griffink3/sak-redesign/Finite Element/Utensil_Lock_2_Stress_Plot.PNG

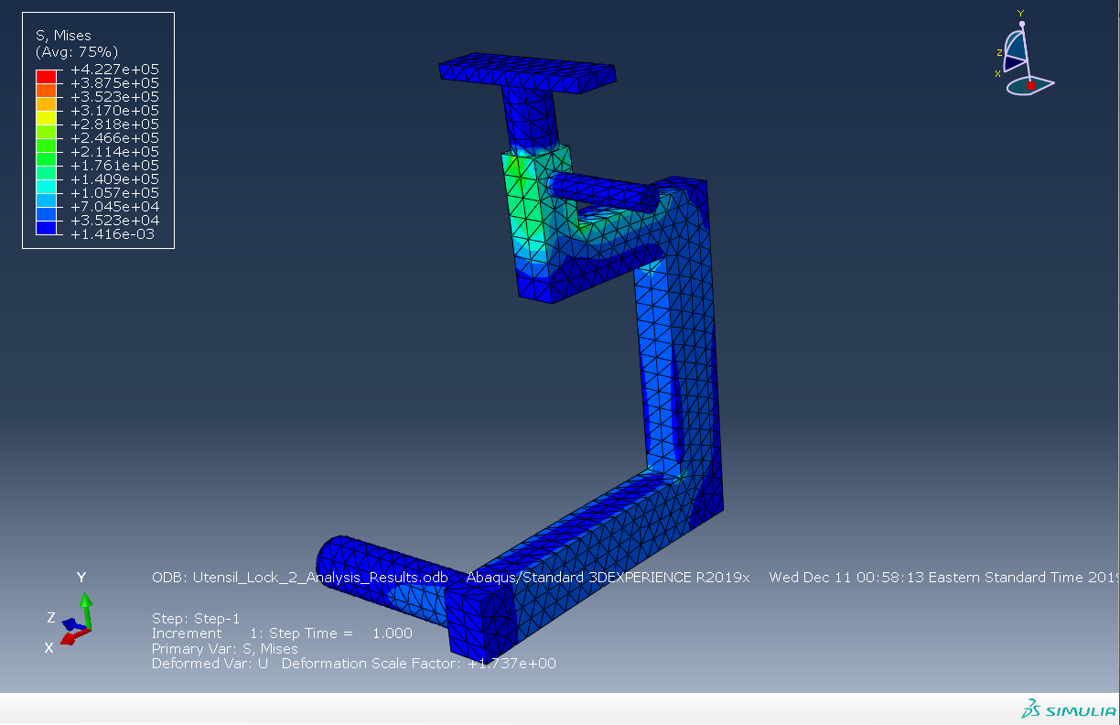
Finite Element/Utensil_Lock_2_Stress_Plot.PNG
