griffink3/sak-redesign/Finite Element/Bottle_Opener_Plot.PNG

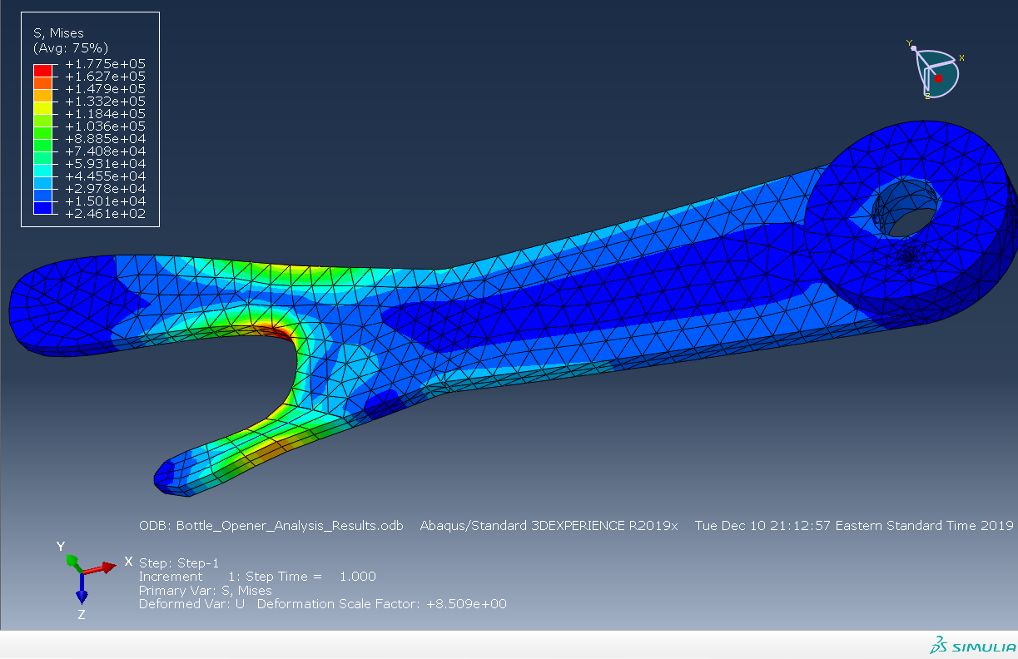
Finite Element/Bottle_Opener_Plot.PNG
