griffink3/sak-redesign/Finite Element/Fork_Stress_Plot.PNG

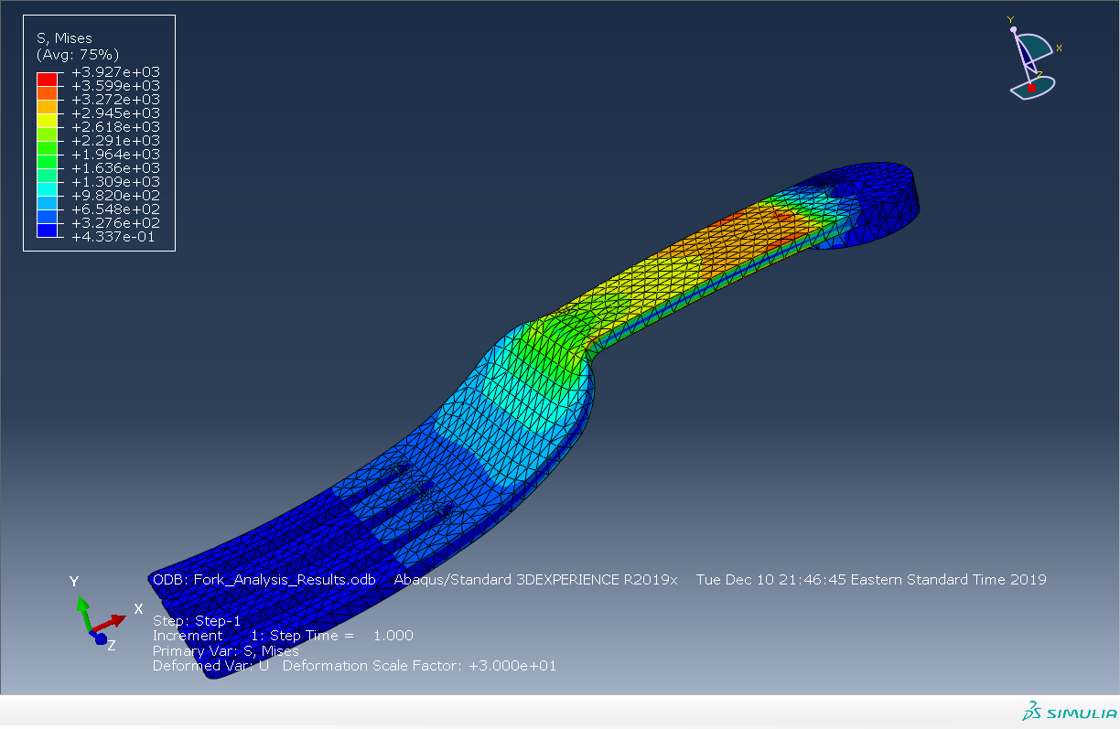
Finite Element/Fork_Stress_Plot.PNG
