griffink3/sak-redesign/Finite Element/Knife_Stress_Plot.PNG

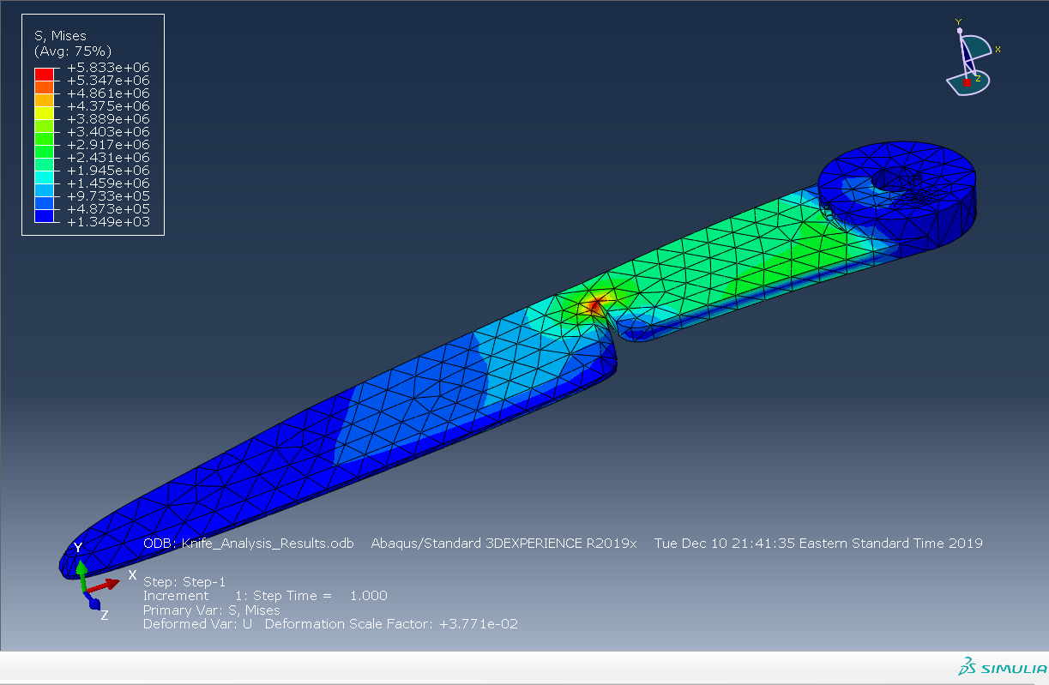
Finite Element/Knife_Stress_Plot.PNG
