griffink3/sak-redesign/Finite Element/Spoon_Stress_Plot.PNG

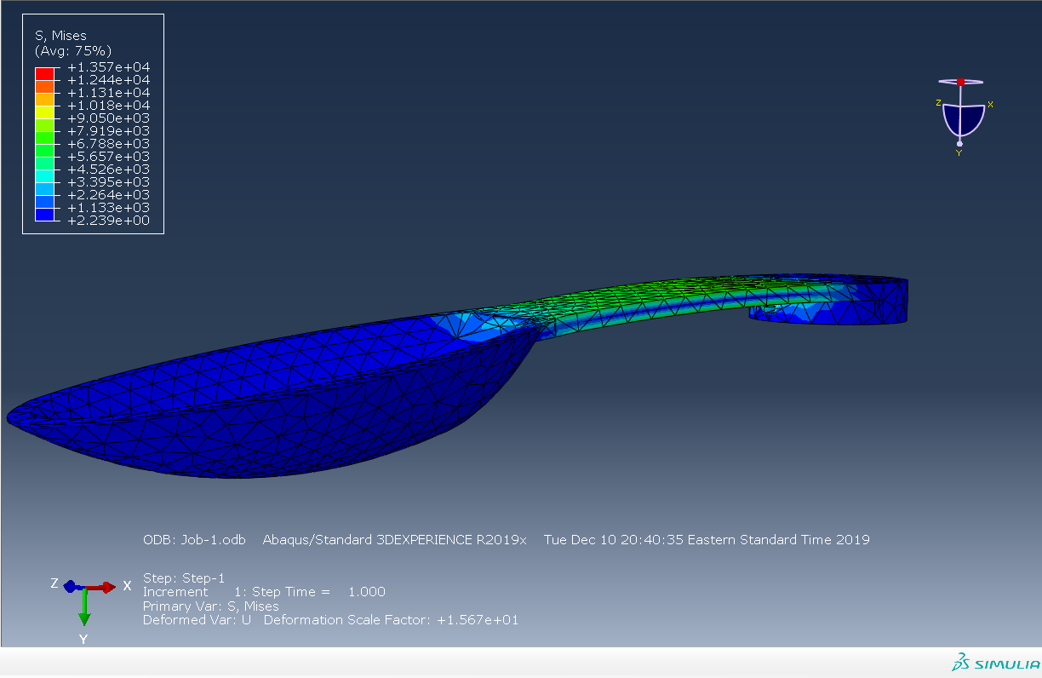
Finite Element/Spoon_Stress_Plot.PNG
