griffink3/sak-redesign/Finite Element/Utensil_Lock_1_Stress_Plot.PNG

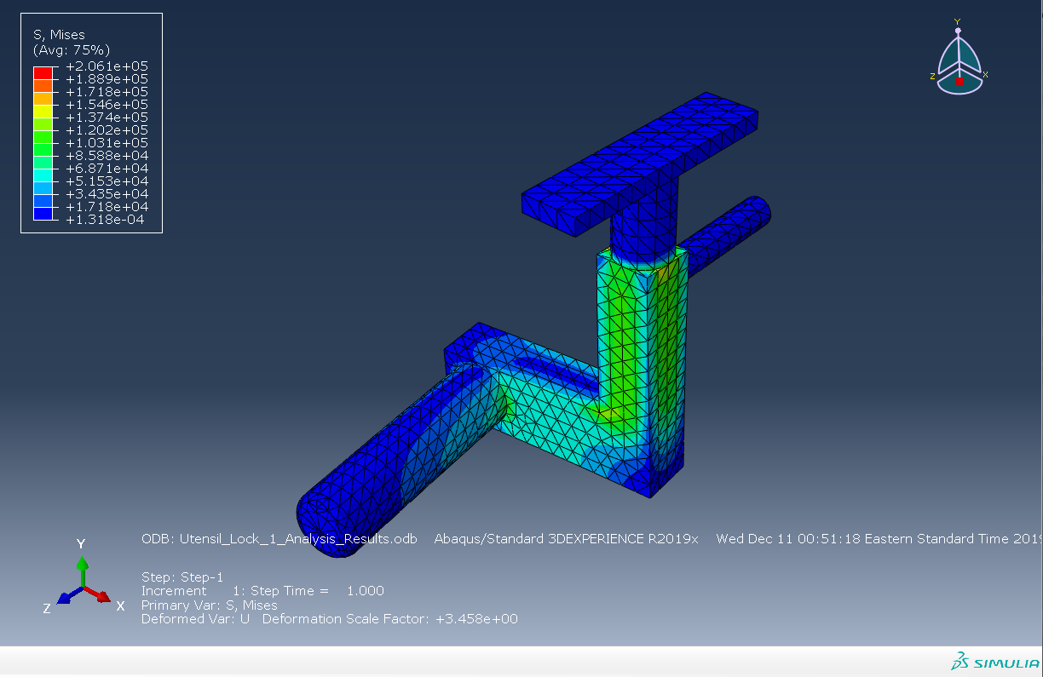
Finite Element/Utensil_Lock_1_Stress_Plot.PNG
