griffink3/sak-redesign/CAM /Top_Rotation_Piece_CAM.SLDPRT

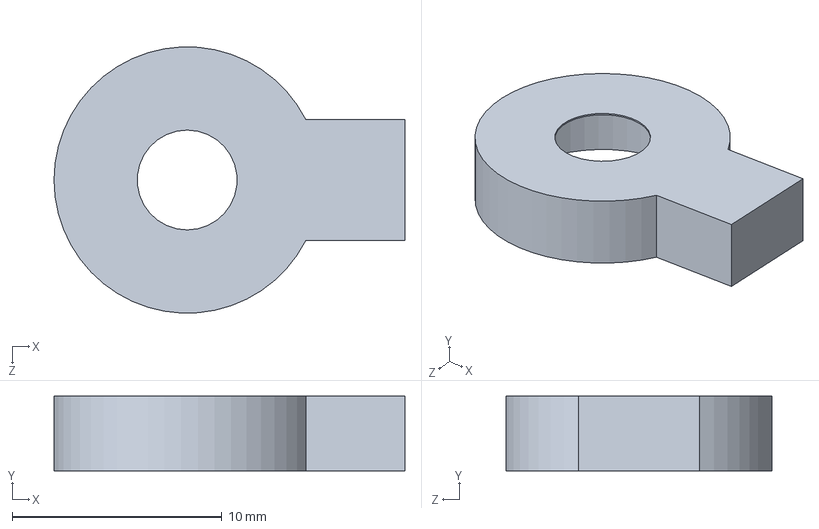
[picture p16: CAD file, 2019-12-22]
CAM /Top_Rotation_Piece_CAM.SLDPRT
16.7 x 3.56 x 12.7 mm
