griffink3/sak-redesign/CAM /Utensil_Bottle_Opener_CAM.SLDPRT

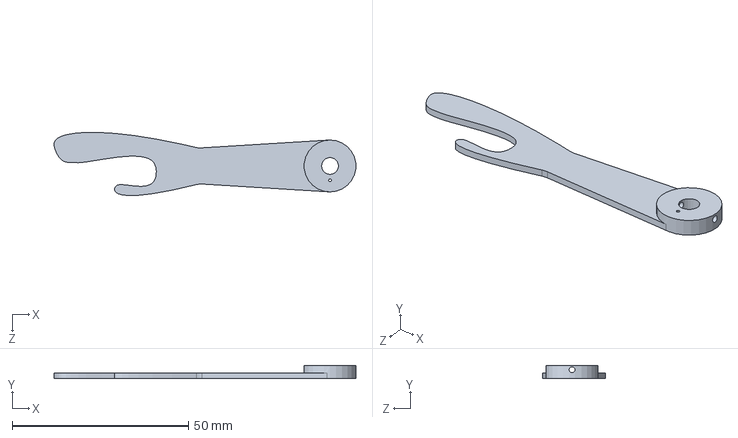
[picture p17: CAD file, 2019-12-22]
CAM /Utensil_Bottle_Opener_CAM.SLDPRT
85.7 x 3.81 x 17.9 mm
