griffink3/sak-redesign/Design Package/Assembly_Drawings.PDF

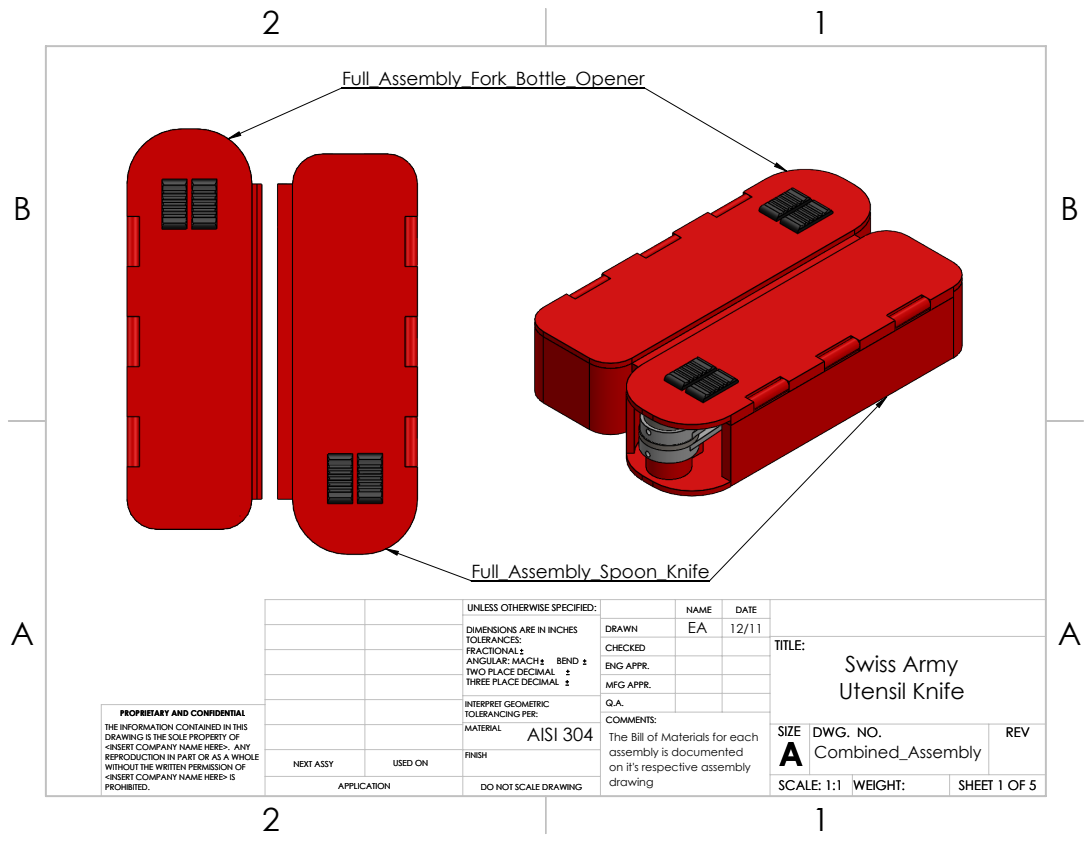
[picture p18: page 1]
SHEET 1 OF 5; SCALE: 1:1; WEIGHT:; PROHIBITED.; DO NOT SCALE DRAWING

UNLESS OTHERWISE SPECIFIED: | | NAME | DATE
DIMENSIONS ARE IN INCHES DIMENSIONS ARE IN INCHES TOLERANCES: TOLERANCES: FRACTIONAL FRACTIONAL ANGULAR: MACH ANGULAR: MACH BEND BEND TWO PLACE DECIMAL TWO PLACE DECIMAL THREE PLACE DECIMAL THREE PLACE DECIMAL | DRAWN | EA | 12/11

CHECKED | | | TITLE: TITLE: Swiss Army Utensil Knife

ENG APPR.
MFG APPR.

INTERPRET GEOMETRIC INTERPRET GEOMETRIC TOLERANCING PER: TOLERANCING PER: | Q.A.
MATERIAL MATERIAL AISI 304 | | SIZE SIZE A A | DWG. NO. DWG. NO. Combined_Assembly | REV

PROPRIETARY AND CONFIDENTIAL
THE INFORMATION CONTAINED IN THIS
DRAWING IS THE SOLE PROPERTY OF
<INSERT COMPANY NAME HERE>. ANY
REPRODUCTION IN PART OR AS A WHOLE
WITHOUT THE WRITTEN PERMISSION OF
<INSERT COMPANY NAME HERE> IS
PROHIBITED.

COMMENTS:
The Bill of Materials for each
assembly is documented
on it's respective assembly
drawing

NEXT ASSY | USED ON | FINISH

DO NOT SCALE DRAWING

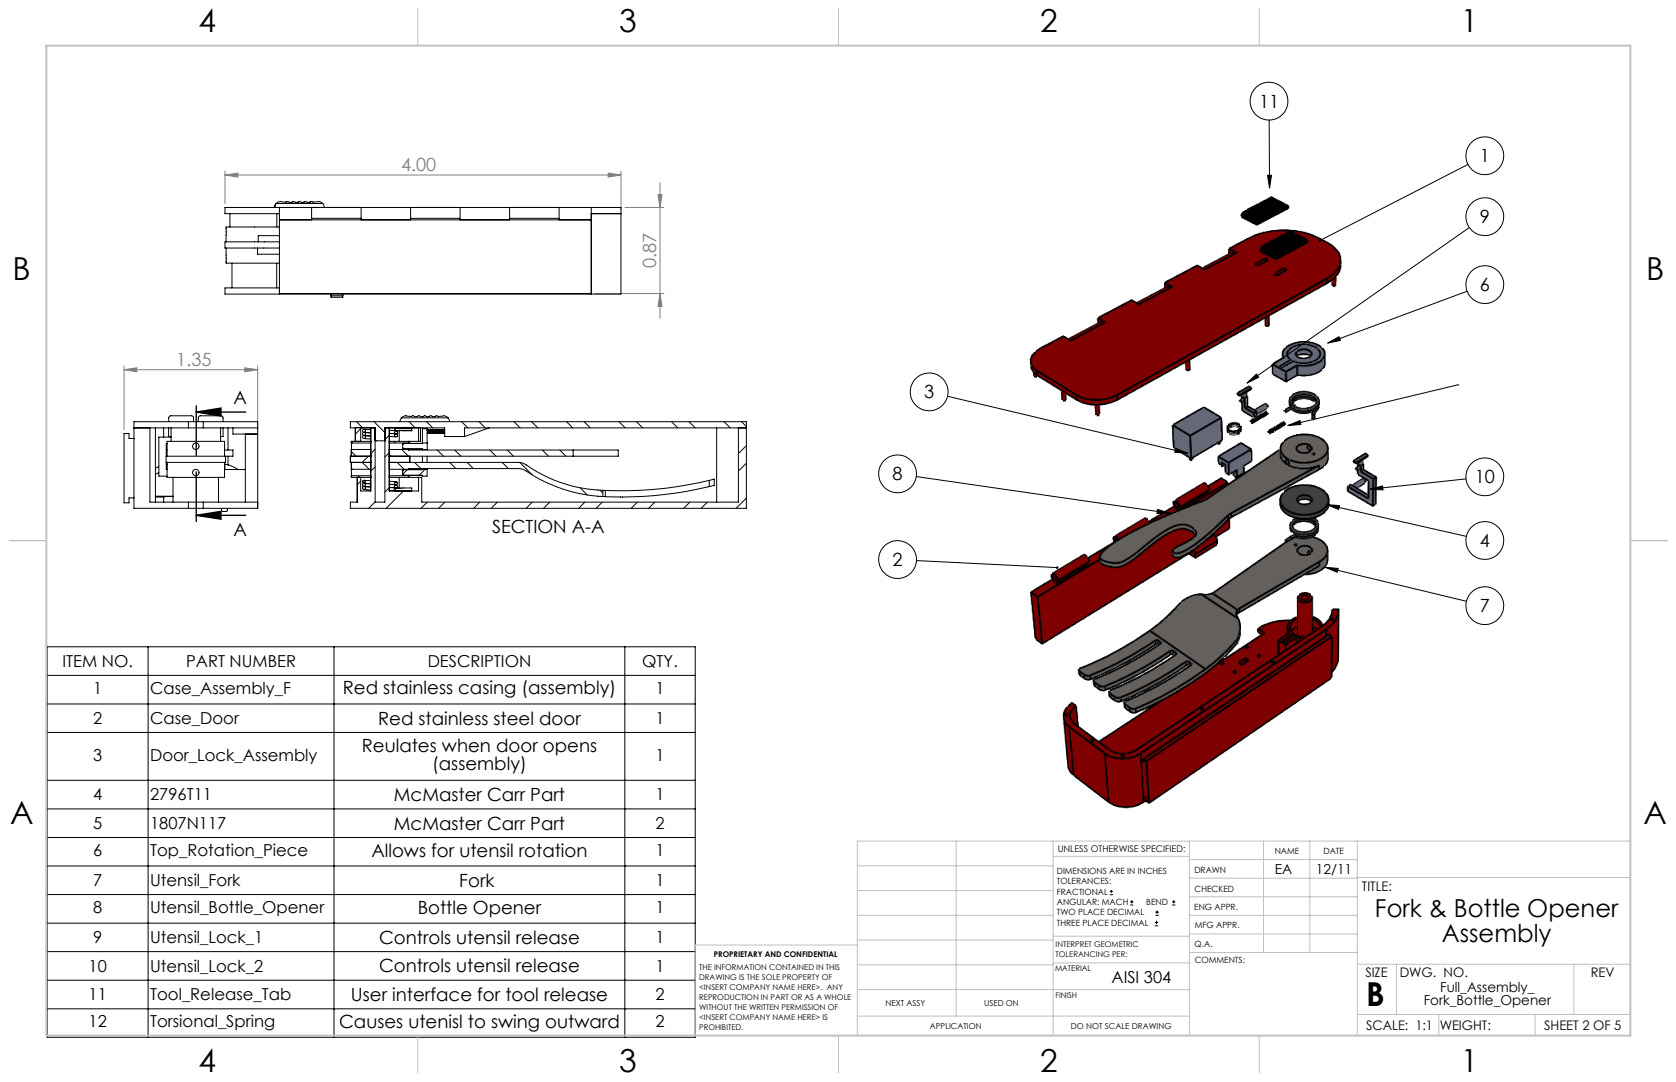
[picture p19: page 2]
SECTION A-A; Utensil_Bottle_Opener; Bottle Opener; Utensil_Lock_2; Controls utensil release; ENG APPR.

ITEM NO. | PART NUMBER | DESCRIPTION | QTY.
1 | Case_Assembly_F | Red stainless casing (assembly) | 1
2 | Case_Door | Red stainless steel door | 1
3 | Door_Lock_Assembly | Reulates when door opens (assembly) | 1

4 | 2796T11 | McMaster Carr Part | 1
5 | 1807N117 | McMaster Carr Part | 2
6 | Top_Rotation_Piece | Allows for utensil rotation | 1
7 | Utensil_Fork | Fork | 1

UNLESS OTHERWISE SPECIFIED: | | NAME | DATE
DIMENSIONS ARE IN INCHES TOLERANCES: FRACTIONAL ANGULAR: MACH BEND TWO PLACE DECIMAL THREE PLACE DECIMAL | DRAWN | EA | 12/11

CHECKED | | | TITLE: Fork & Bottle Opener Assembly

9 | Utensil_Lock_1 | Controls utensil release | 1

MFG APPR.

INTERPRET GEOMETRIC TOLERANCING PER: | Q.A.
MATERIAL AISI 304 | | SIZE B | DWG. NO. Full_Assembly_ Fork_Bottle_Opener | REV

PROPRIETARY AND CONFIDENTIAL
THE INFORMATION CONTAINED IN THIS
DRAWING IS THE SOLE PROPERTY OF
<INSERT COMPANY NAME HERE>. ANY
REPRODUCTION IN PART OR AS A WHOLE
WITHOUT THE WRITTEN PERMISSION OF

11 | Tool_Release_Tab | User interface for tool release | 2
12 | Torsional_Spring | Causes utenisl to swing outward | 2

NEXT ASSY | USED ON | FINISH

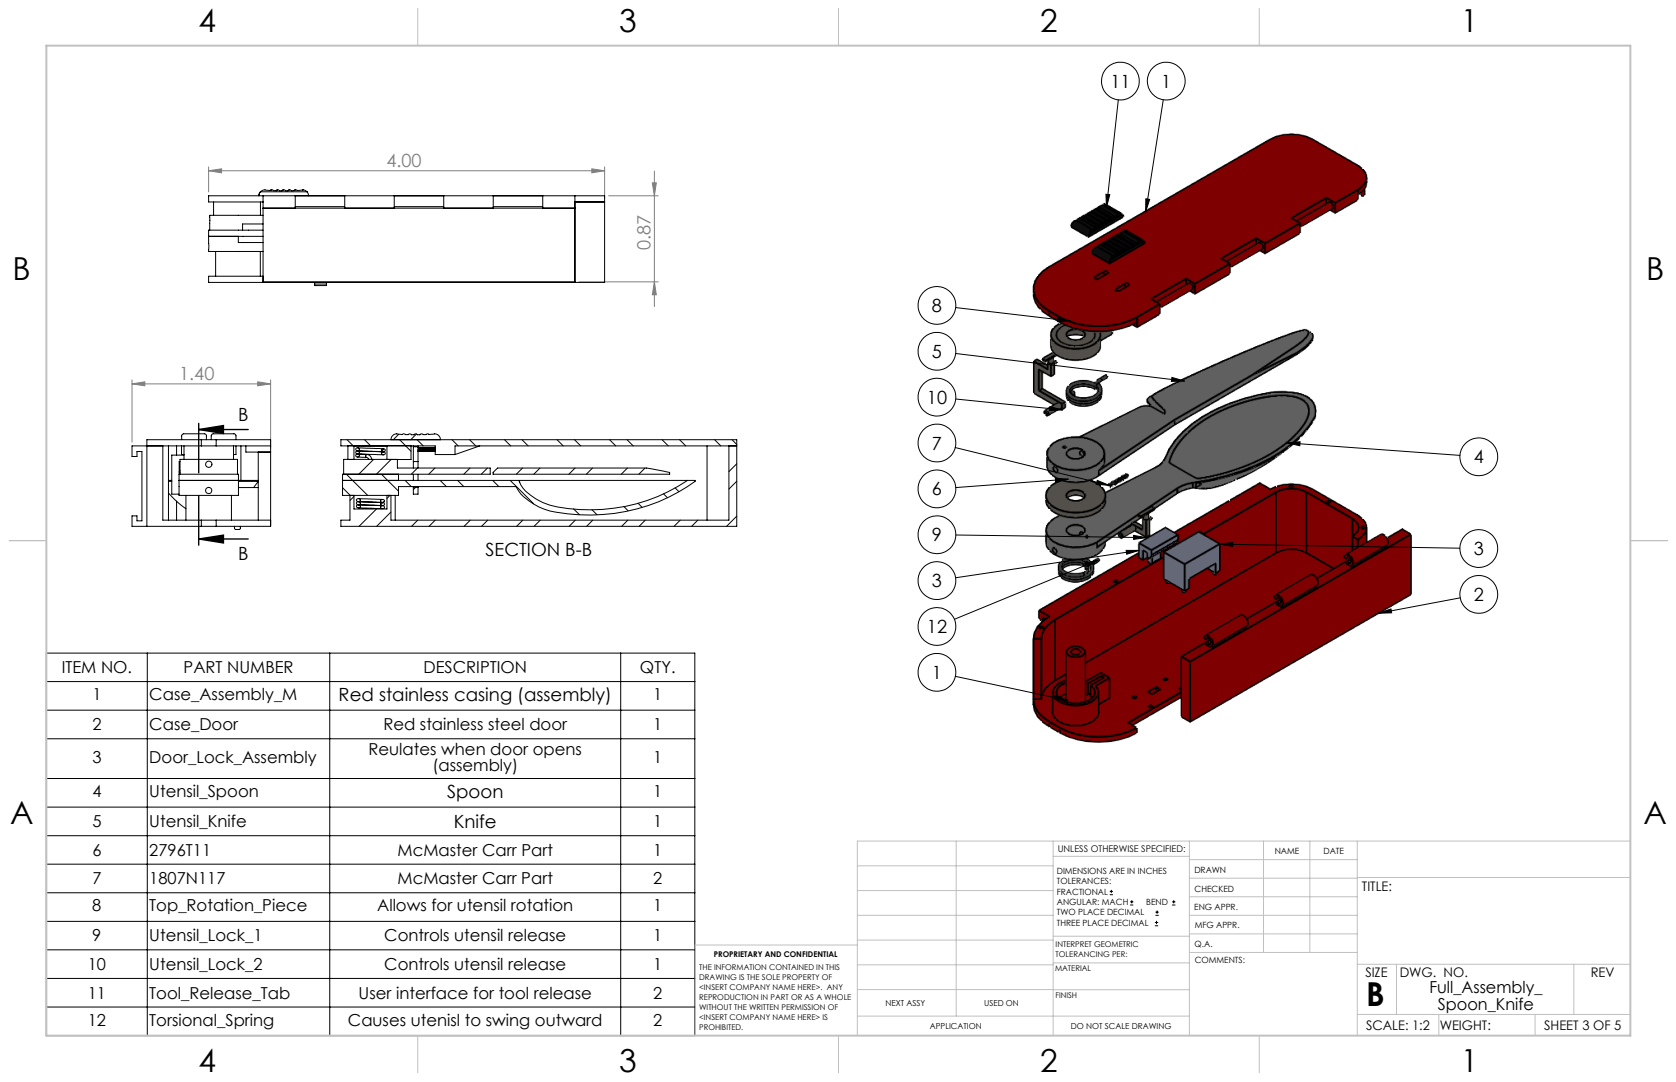
[picture p20: page 3]
SECTION B-B; Utensil_Lock_2; Controls utensil release

ITEM NO. | PART NUMBER | DESCRIPTION | QTY.
1 | Case_Assembly_M | Red stainless casing (assembly) | 1
2 | Case_Door | Red stainless steel door | 1
3 | Door_Lock_Assembly | Reulates when door opens (assembly) | 1
4 | Utensil_Spoon | Spoon | 1
5 | Utensil_Knife | Knife | 1
6 | 2796T11 | McMaster Carr Part | 1
7 | 1807N117 | McMaster Carr Part | 2
8 | Top_Rotation_Piece | Allows for utensil rotation | 1
9 | Utensil_Lock_1 | Controls utensil release | 1

UNLESS OTHERWISE SPECIFIED: | | NAME | DATE
DIMENSIONS ARE IN INCHES TOLERANCES: FRACTIONAL ANGULAR: MACH BEND TWO PLACE DECIMAL THREE PLACE DECIMAL | DRAWN

CHECKED | | | TITLE:

ENG APPR.
MFG APPR.

INTERPRET GEOMETRIC TOLERANCING PER: | Q.A.
MATERIAL | | SIZE B | DWG. NO. Full_Assembly_ Spoon_Knife | REV

PROPRIETARY AND CONFIDENTIAL
THE INFORMATION CONTAINED IN THIS
DRAWING IS THE SOLE PROPERTY OF
<INSERT COMPANY NAME HERE>. ANY
REPRODUCTION IN PART OR AS A WHOLE
WITHOUT THE WRITTEN PERMISSION OF

11 | Tool_Release_Tab | User interface for tool release | 2
NEXT ASSY | USED ON | FINISH DO NOT SCALE DRAWING
12 | Torsional_Spring | Causes utenisl to swing outward | 2

SCALE: 1:2 | WEIGHT:

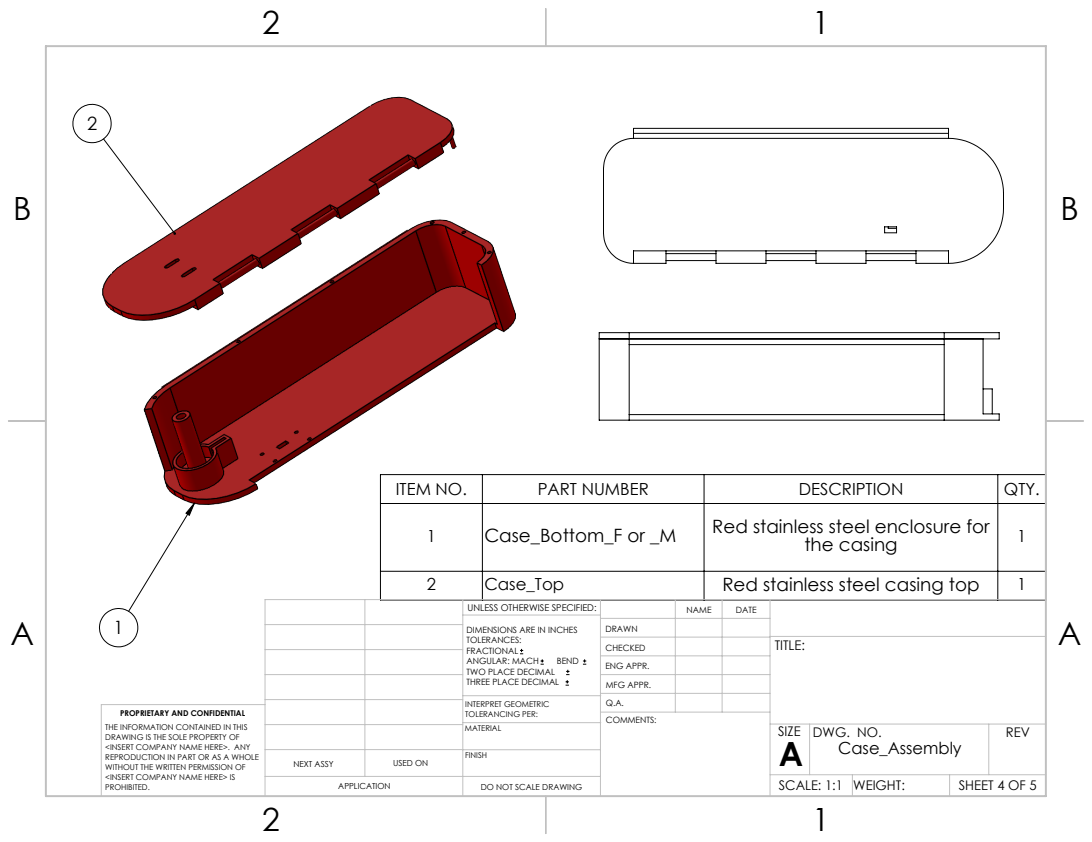
[picture p21: page 4]

ITEM NO. | PART NUMBER | DESCRIPTION | QTY.
1 | Case_Bottom_F or _M | Red stainless steel enclosure for the casing | 1

2 | Case_Top | Red stainless steel casing top | 1

UNLESS OTHERWISE SPECIFIED: | | NAME | DATE
DIMENSIONS ARE IN INCHES TOLERANCES: FRACTIONAL ANGULAR: MACH BEND TWO PLACE DECIMAL THREE PLACE DECIMAL | DRAWN

CHECKED | | | TITLE:

ENG APPR.
MFG APPR.

INTERPRET GEOMETRIC TOLERANCING PER: | Q.A.
MATERIAL | | SIZE A | DWG. NO. Case_Assembly | REV

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

NEXT ASSY | USED ON | FINISH

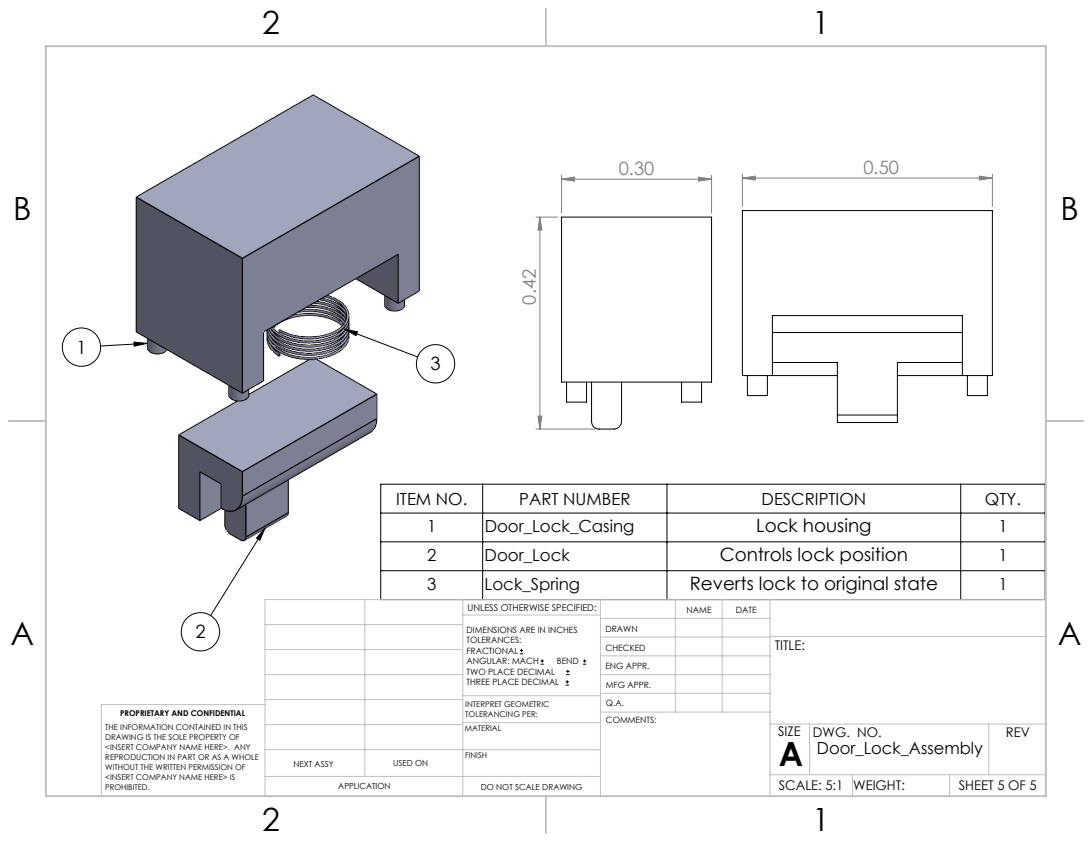
[picture p22: page 5]

ITEM NO. | PART NUMBER | DESCRIPTION | QTY.
1 | Door_Lock_Casing | Lock housing | 1
2 | Door_Lock | Controls lock position | 1
3 | Lock_Spring | Reverts lock to original state | 1

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

CHECKED | | | TITLE:

ENG APPR.
MFG APPR.

INTERPRET GEOMETRIC TOLERANCING PER: | Q.A.
MATERIAL | | SIZE A | DWG. NO. Door_Lock_Assembly | REV

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

NEXT ASSY | USED ON | FINISH

SCALE: 5:1 | WEIGHT:
