griffink3/sak-redesign/Design Package/Individual_Part_Drawings_No_Tolerance.PDF

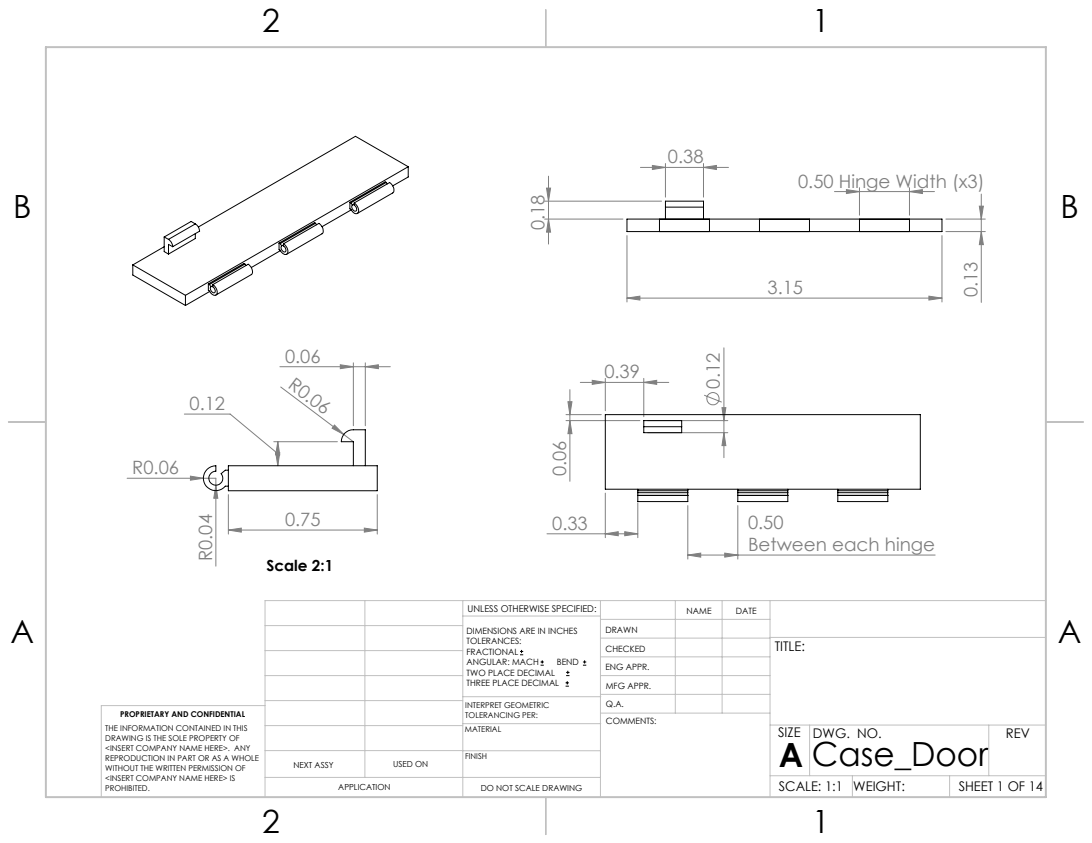
[picture p23: page 1]
0.50 Hinge Width (x3); Scale 2:1

Between each hinge

UNLESS OTHERWISE SPECIFIED: | | NAME | DATE
DIMENSIONS ARE IN INCHES TOLERANCES: FRACTIONAL ANGULAR: MACH BEND TWO PLACE DECIMAL THREE PLACE DECIMAL | DRAWN

CHECKED | | | TITLE:

ENG APPR.
MFG APPR.

INTERPRET GEOMETRIC TOLERANCING PER: | Q.A.
MATERIAL | | SIZE A | DWG. NO. Case_Door | REV

PROPRIETARY AND CONFIDENTIAL
THE INFORMATION CONTAINED IN THIS
DRAWING IS THE SOLE PROPERTY OF
<INSERT COMPANY NAME HERE>. ANY
REPRODUCTION IN PART OR AS A WHOLE
WITHOUT THE WRITTEN PERMISSION OF
<INSERT COMPANY NAME HERE> IS
PROHIBITED.

NEXT ASSY | USED ON | FINISH

APPLICATION | DO NOT SCALE DRAWING | | SCALE: 1:1 | WEIGHT: | SHEET 1 OF 14

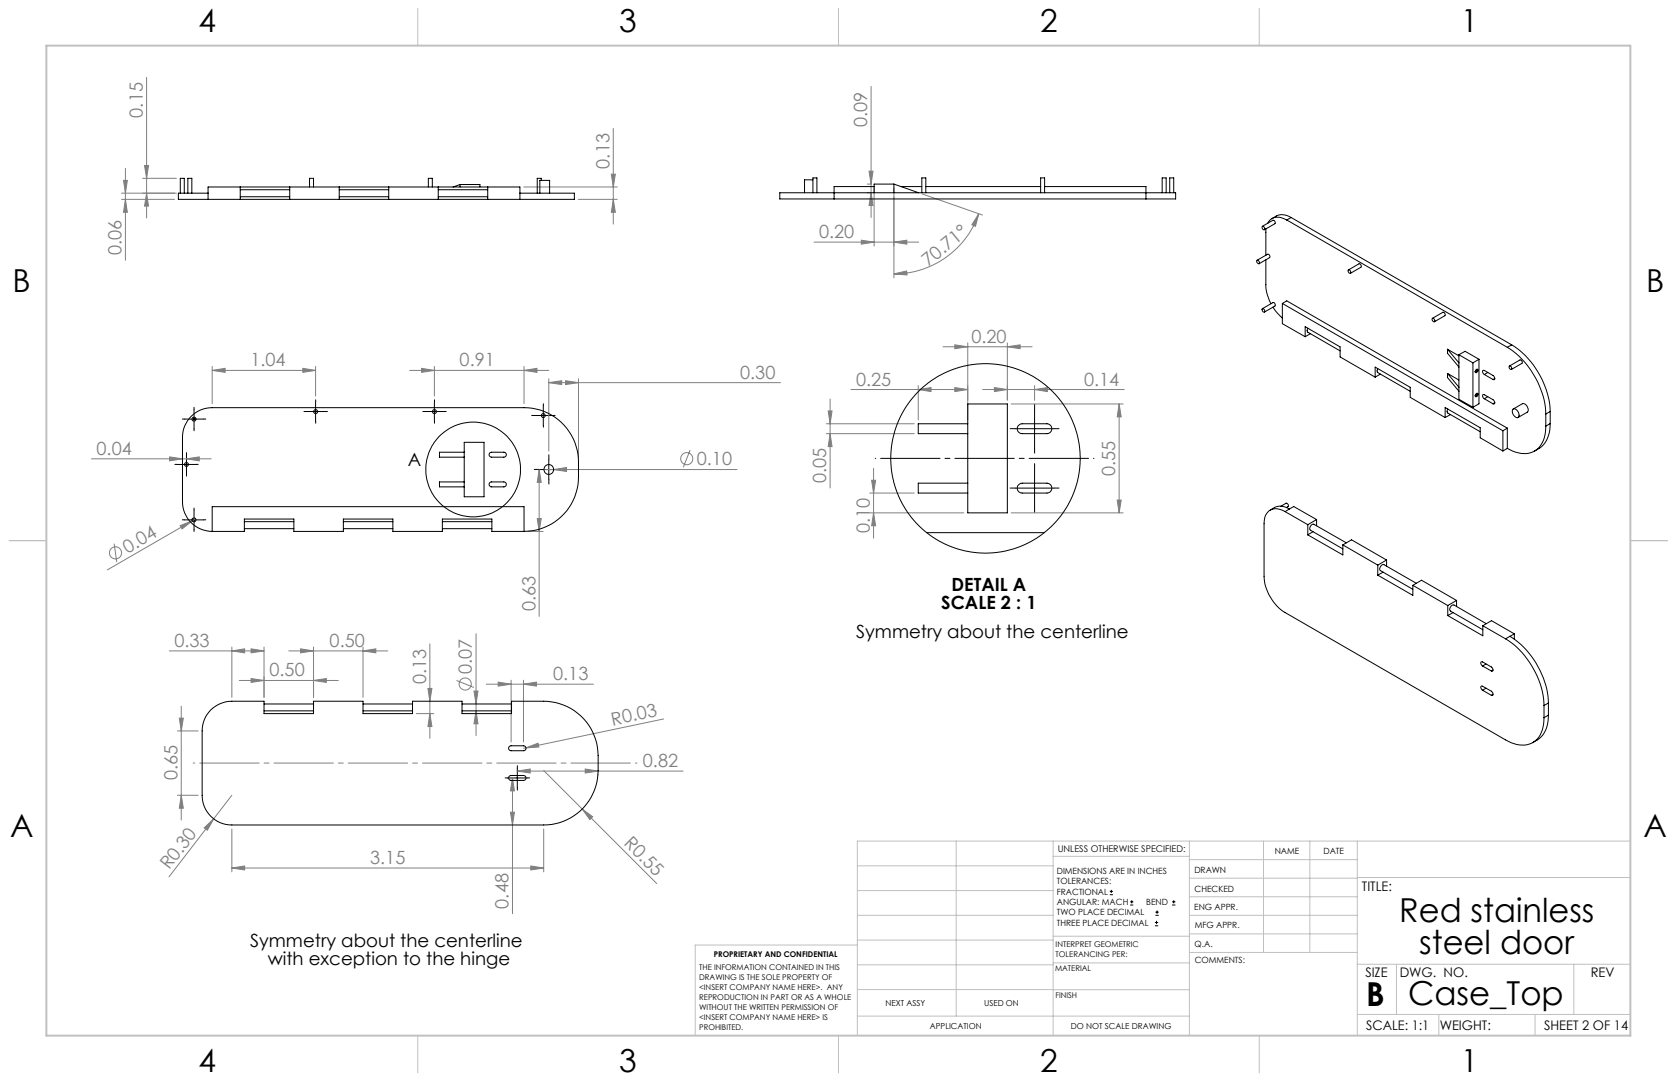
[picture p24: page 2]
DETAIL A SCALE 2 : 1

Symmetry about the centerline

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

CHECKED | | | TITLE: Red stainless steel door

ENG APPR.
MFG APPR.

with exception to the hinge

INTERPRET GEOMETRIC TOLERANCING PER: | Q.A.
MATERIAL | | SIZE B | DWG. NO. Case_Top | REV

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

NEXT ASSY | USED ON | FINISH

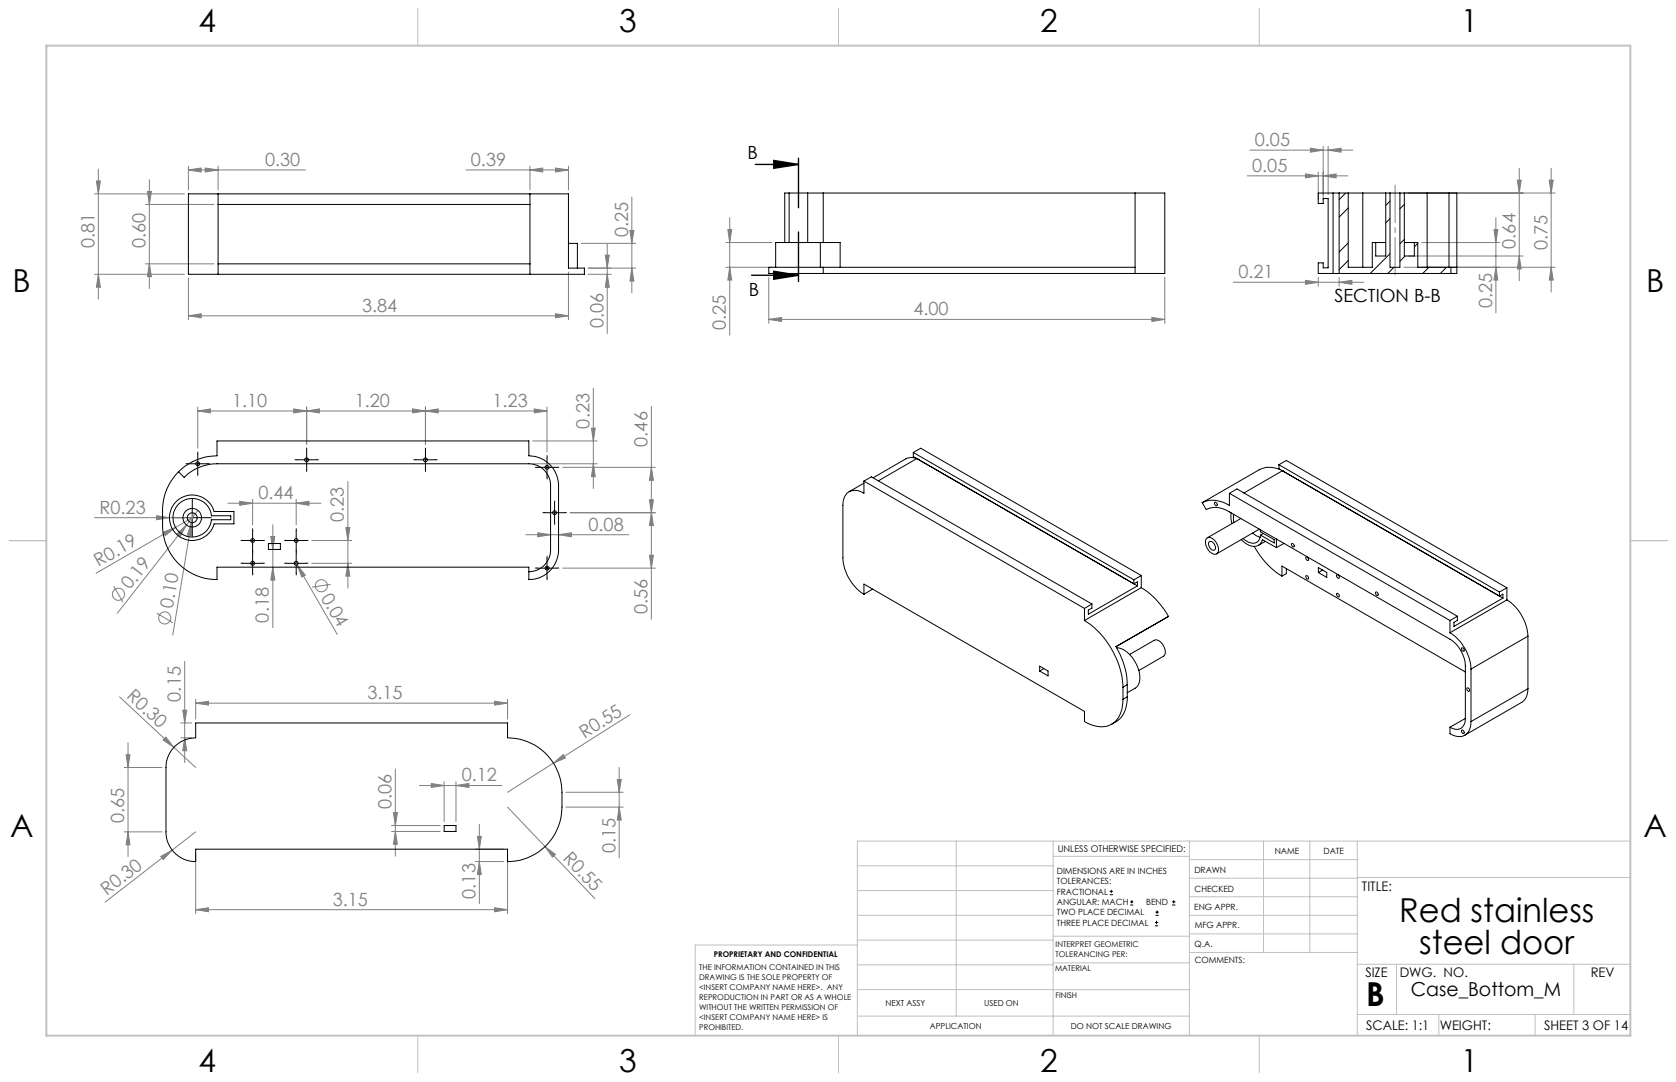
[picture p25: page 3]
SECTION B-B

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

CHECKED | | | TITLE: Red stainless steel door

ENG APPR.
MFG APPR.

INTERPRET GEOMETRIC TOLERANCING PER: | Q.A.
MATERIAL | | SIZE B | DWG. NO. Case_Bottom_M | REV

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

NEXT ASSY | USED ON | FINISH

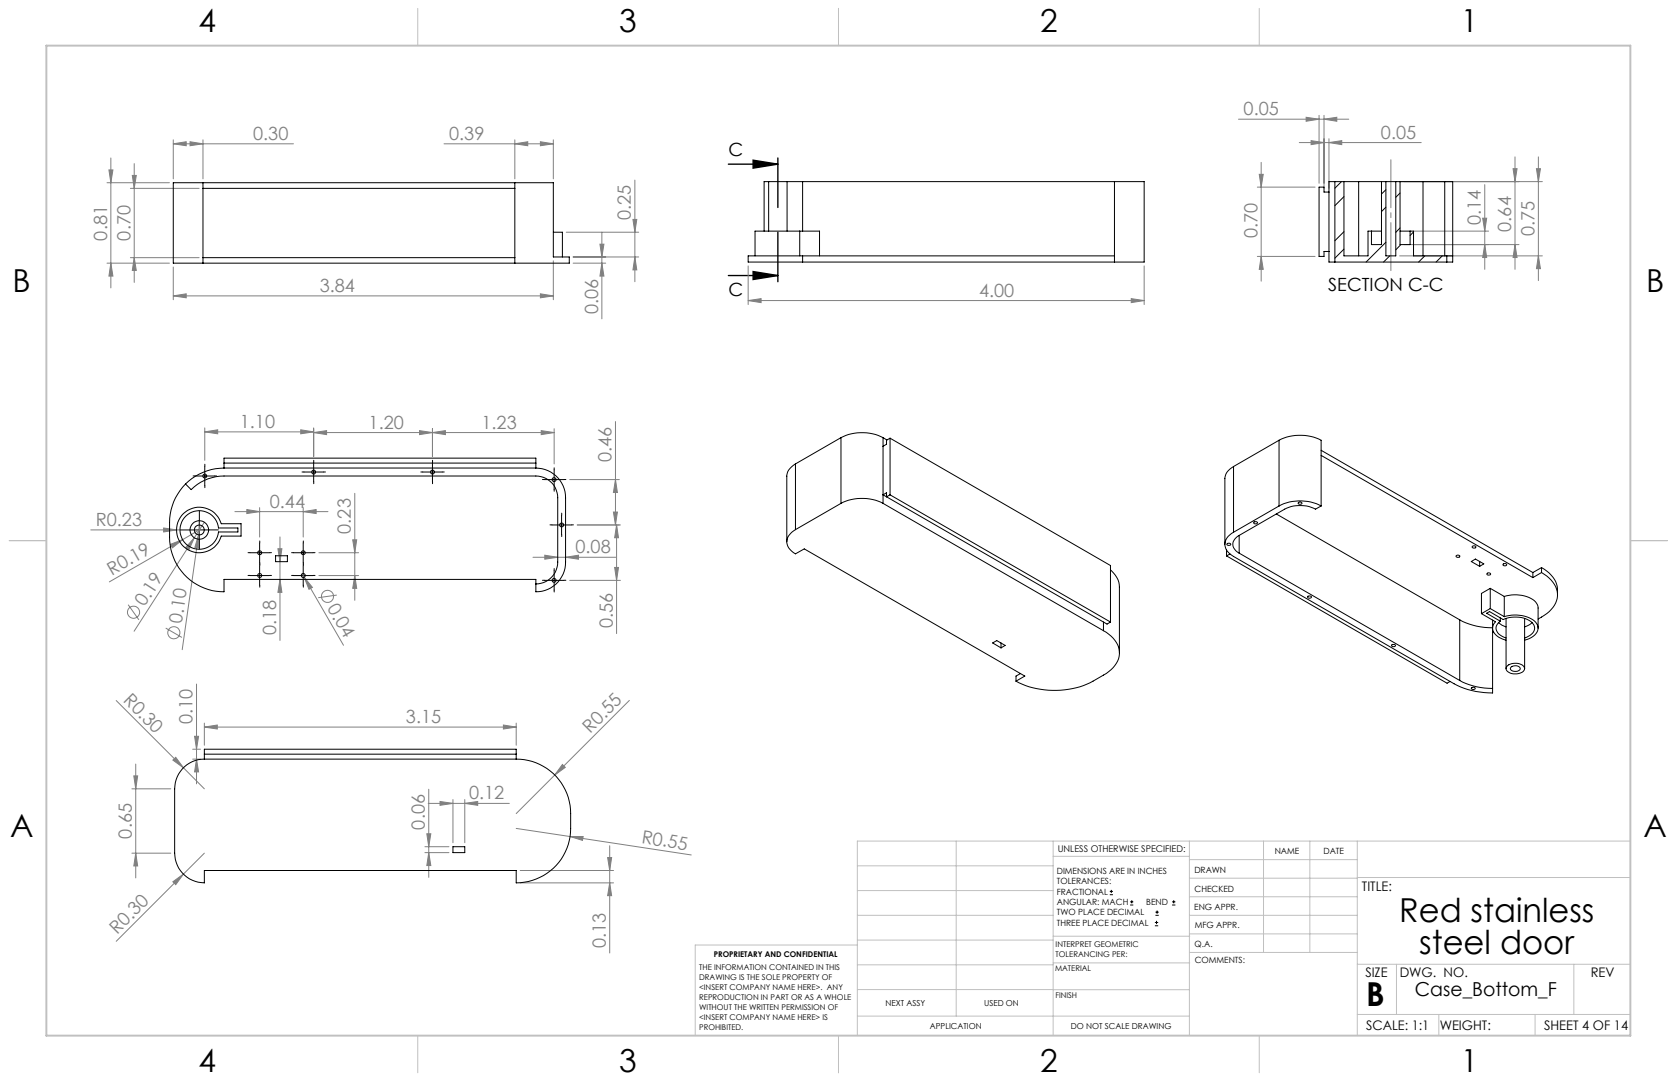
[picture p26: page 4]
SECTION C-C

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

CHECKED | | | TITLE: Red stainless steel door

ENG APPR.
MFG APPR.

INTERPRET GEOMETRIC TOLERANCING PER: | Q.A.
MATERIAL | | SIZE B | DWG. NO. Case_Bottom_F | REV

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

NEXT ASSY | USED ON | FINISH

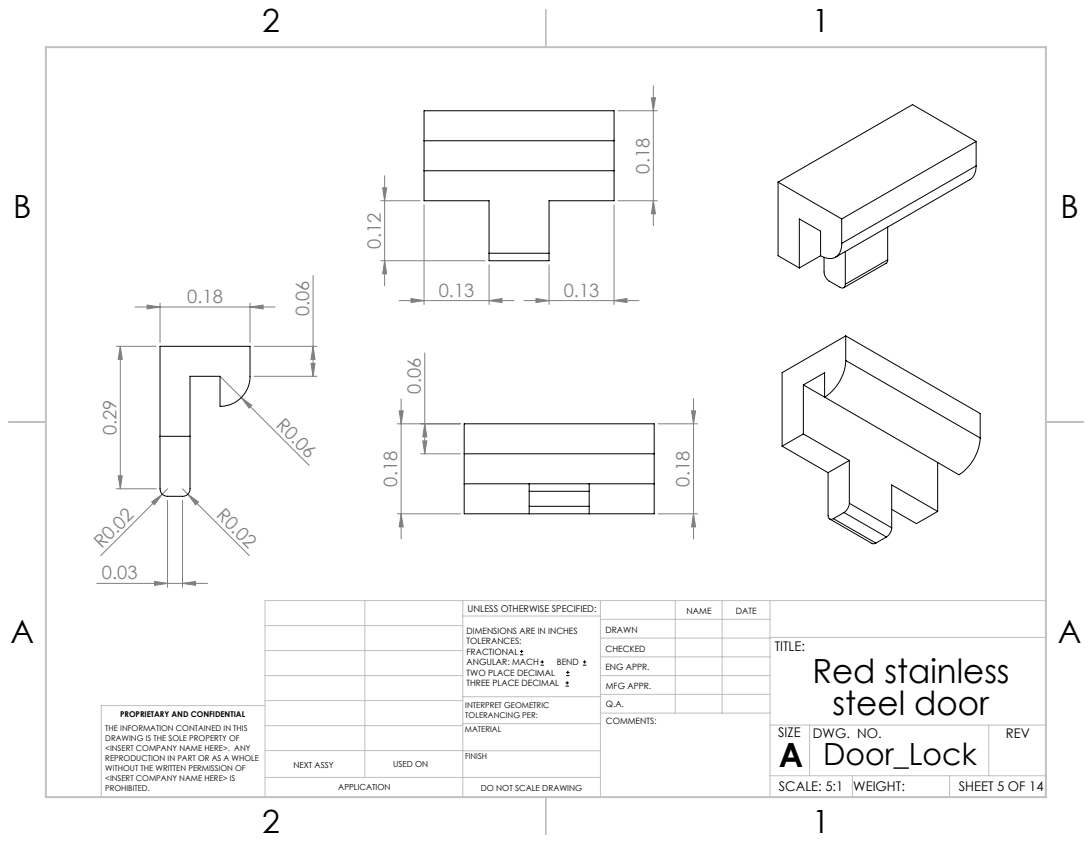
[picture p27: page 5]
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

CHECKED | | | TITLE: Red stainless steel door

ENG APPR.
MFG APPR.

INTERPRET GEOMETRIC TOLERANCING PER: | Q.A.
MATERIAL | | SIZE A | DWG. NO. Door_Lock | REV

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

NEXT ASSY | USED ON | FINISH

SCALE: 5:1 | WEIGHT:

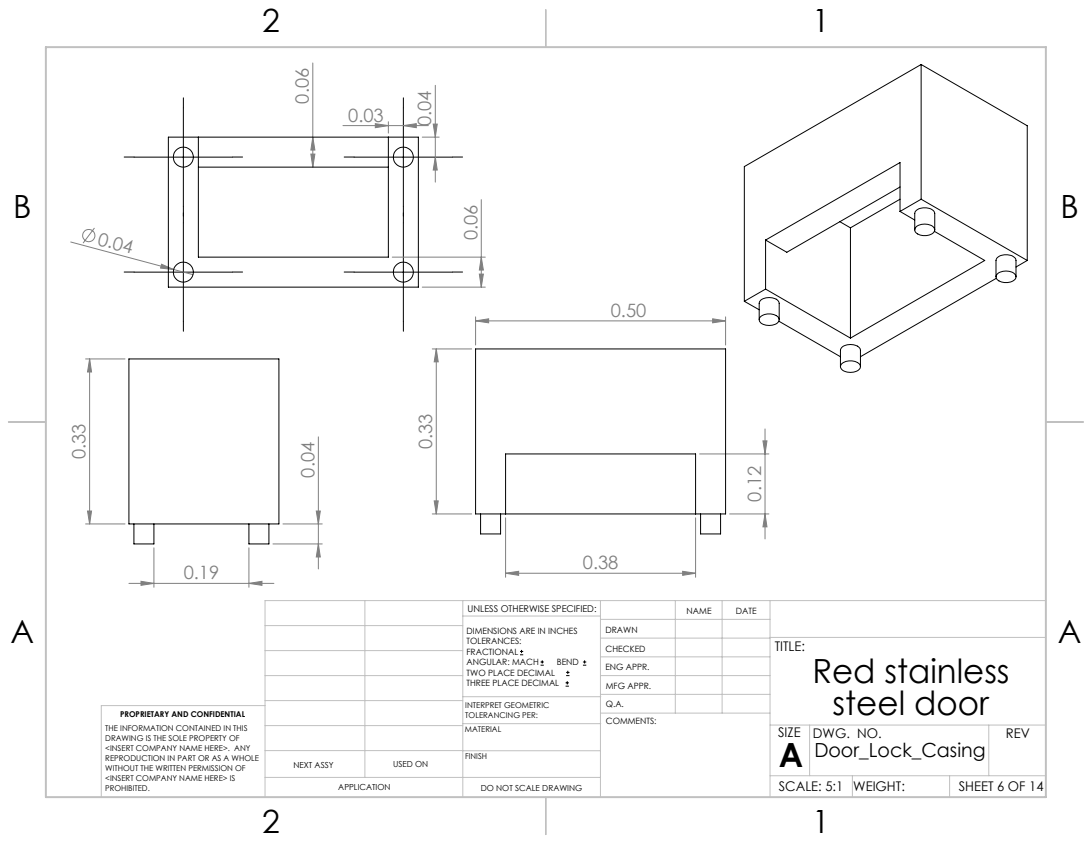
[picture p28: page 6]
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

CHECKED | | | TITLE: Red stainless steel door

ENG APPR.
MFG APPR.

INTERPRET GEOMETRIC TOLERANCING PER: | Q.A.
MATERIAL | | SIZE A | DWG. NO. Door_Lock_Casing | REV

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

NEXT ASSY | USED ON | FINISH

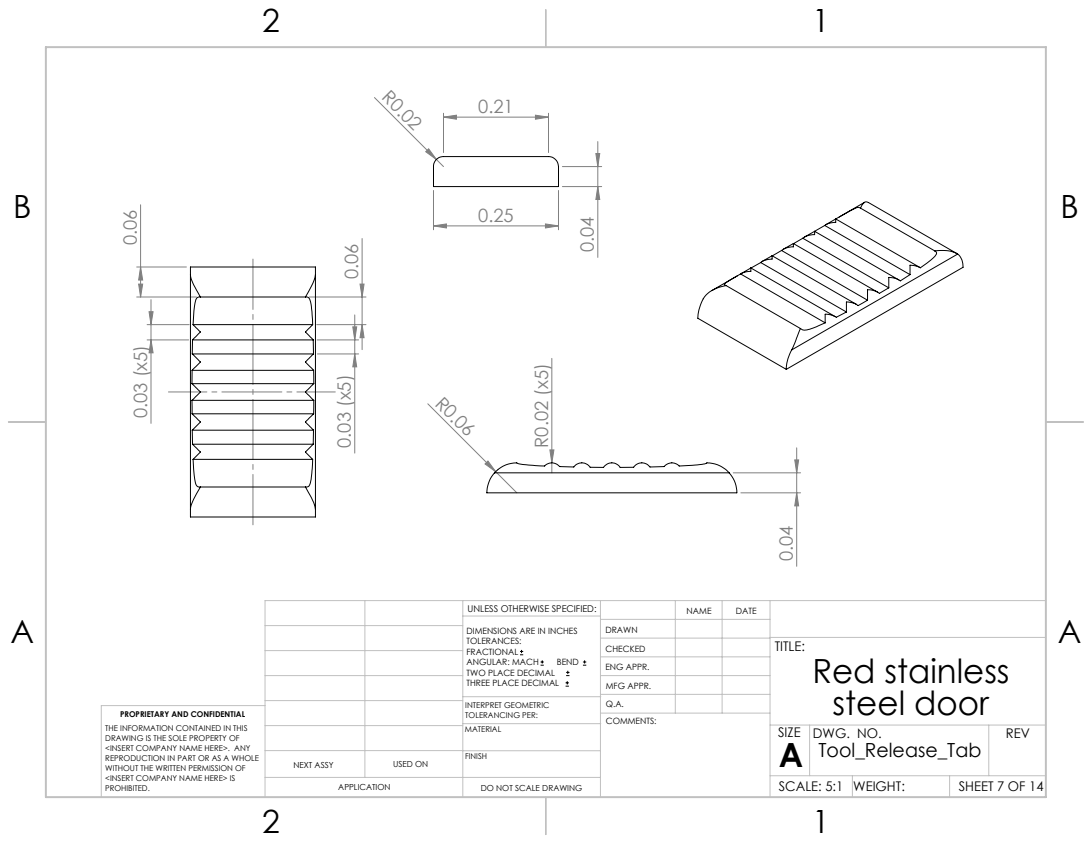
[picture p29: page 7]
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

CHECKED | | | TITLE: Red stainless steel door

ENG APPR.
MFG APPR.

INTERPRET GEOMETRIC TOLERANCING PER: | Q.A.
MATERIAL | | SIZE A | DWG. NO. Tool_Release_Tab | REV

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

NEXT ASSY | USED ON | FINISH

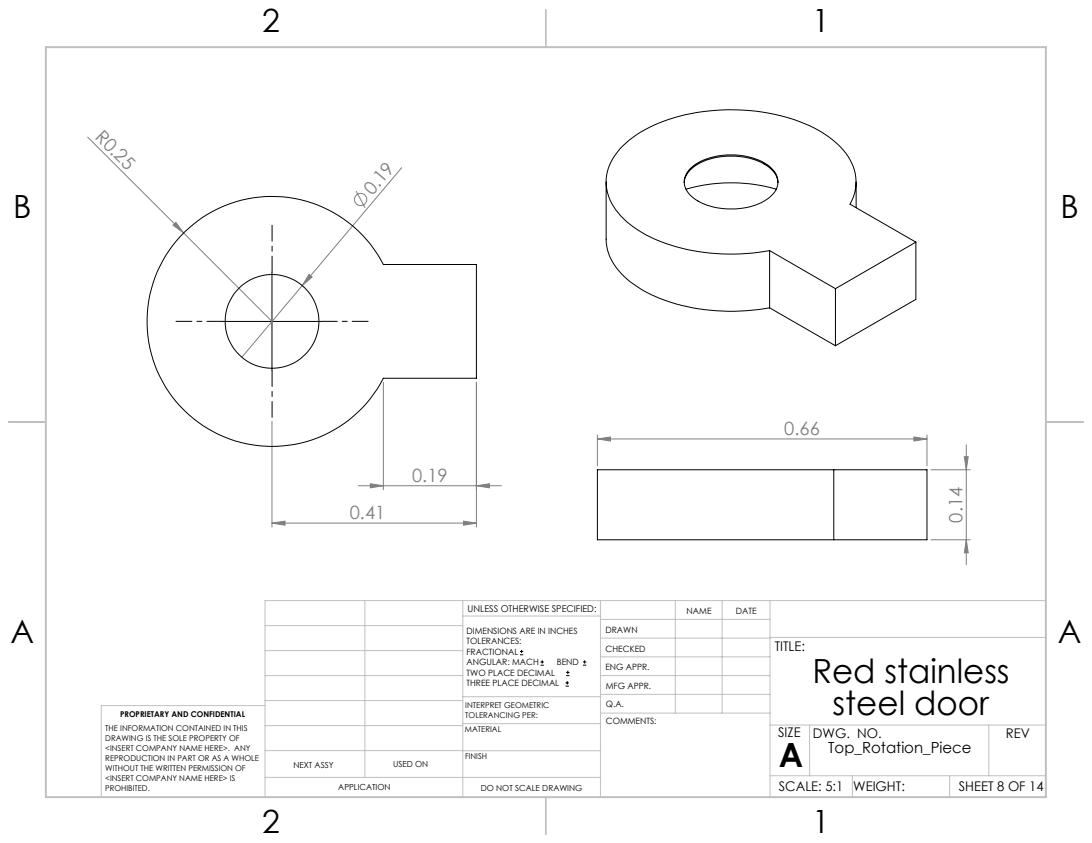
[picture p30: page 8]
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

CHECKED | | | TITLE: Red stainless steel door

ENG APPR.
MFG APPR.

INTERPRET GEOMETRIC TOLERANCING PER: | Q.A.
MATERIAL | | SIZE A | DWG. NO. Top_Rotation_Piece | REV

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

NEXT ASSY | USED ON | FINISH

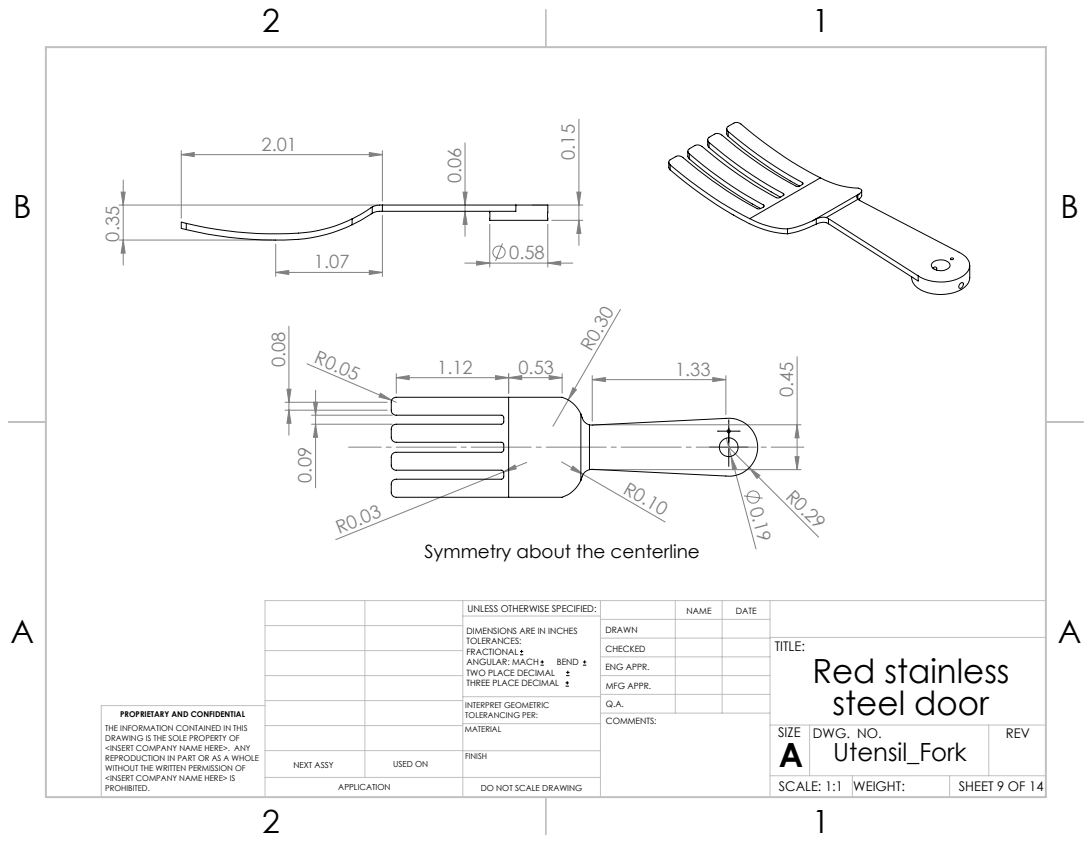
[picture p31: page 9]

Symmetry about the centerline

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

CHECKED | | | TITLE: Red stainless steel door

ENG APPR.
MFG APPR.

INTERPRET GEOMETRIC TOLERANCING PER: | Q.A.
MATERIAL | | SIZE A | DWG. NO. Utensil_Fork | REV

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

NEXT ASSY | USED ON | FINISH

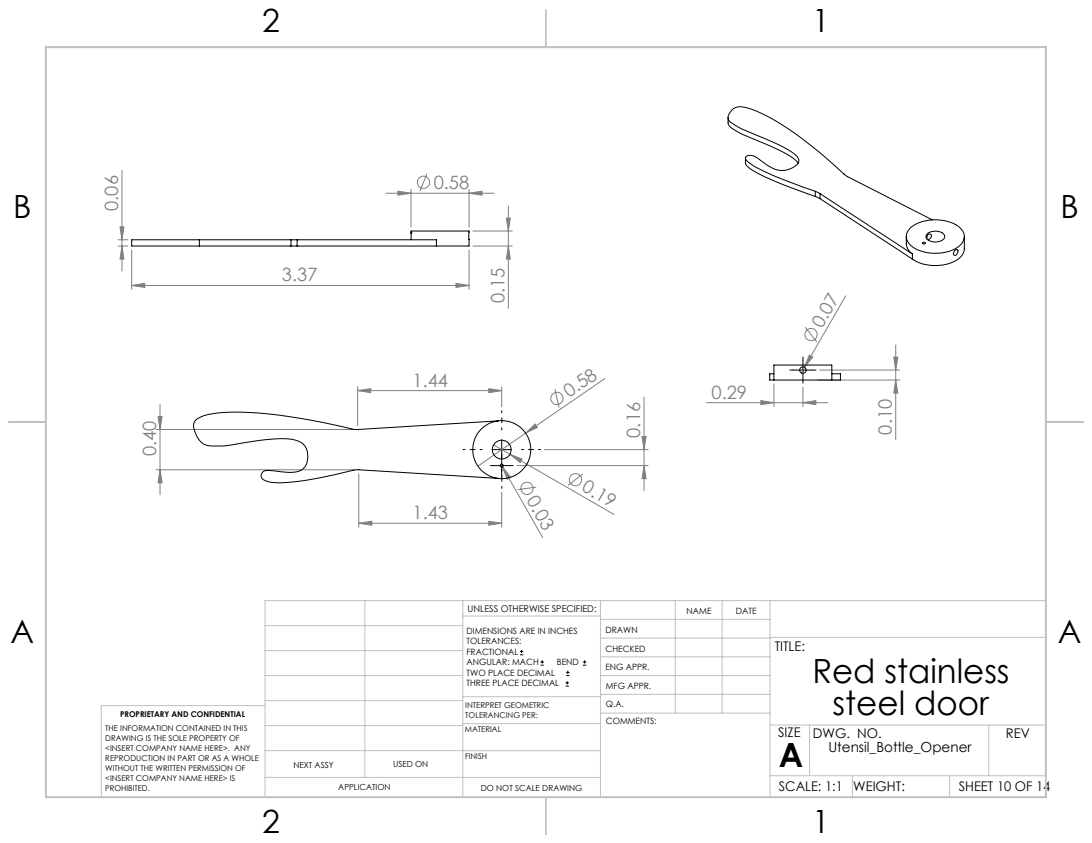
[picture p32: page 10]
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

CHECKED | | | TITLE: Red stainless steel door

ENG APPR.
MFG APPR.

INTERPRET GEOMETRIC TOLERANCING PER: | Q.A.
MATERIAL | | SIZE A | DWG. NO. Utensil_Bottle_Opener | REV

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

NEXT ASSY | USED ON | FINISH

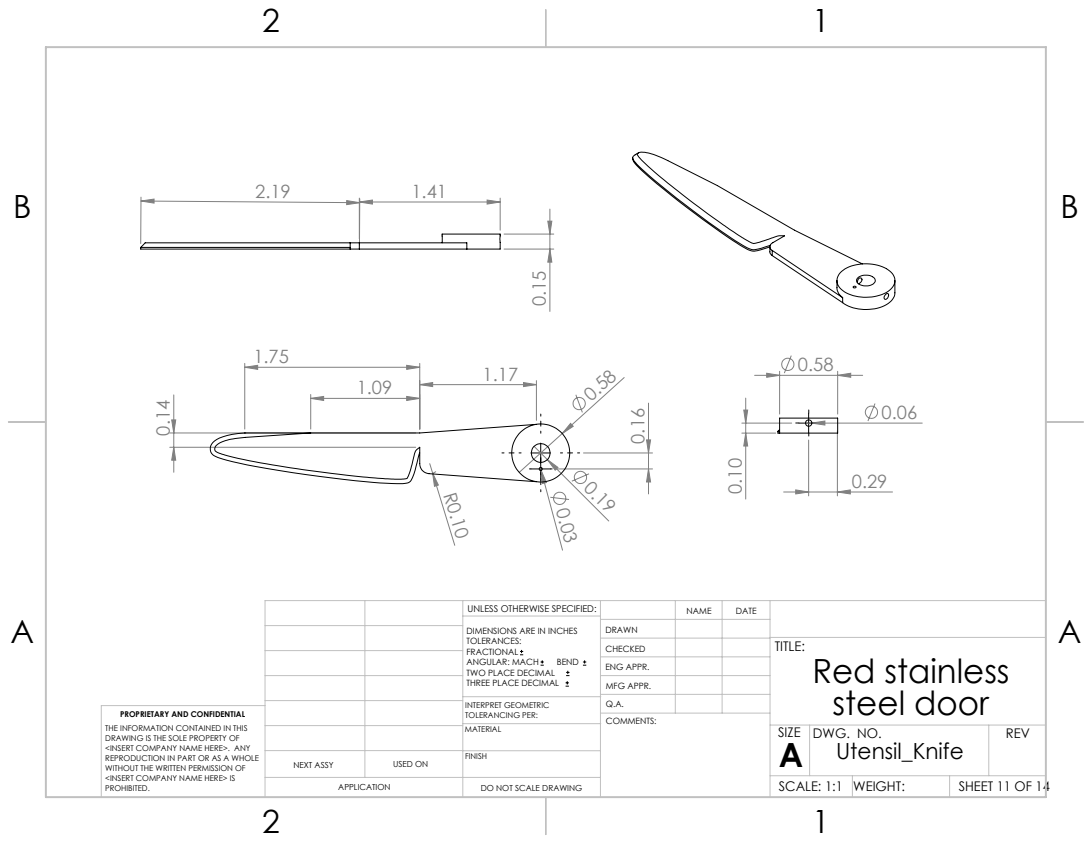
[picture p33: page 11]
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

CHECKED | | | TITLE: Red stainless steel door

ENG APPR.
MFG APPR.

INTERPRET GEOMETRIC TOLERANCING PER: | Q.A.
MATERIAL | | SIZE A | DWG. NO. Utensil_Knife | REV

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

NEXT ASSY | USED ON | FINISH

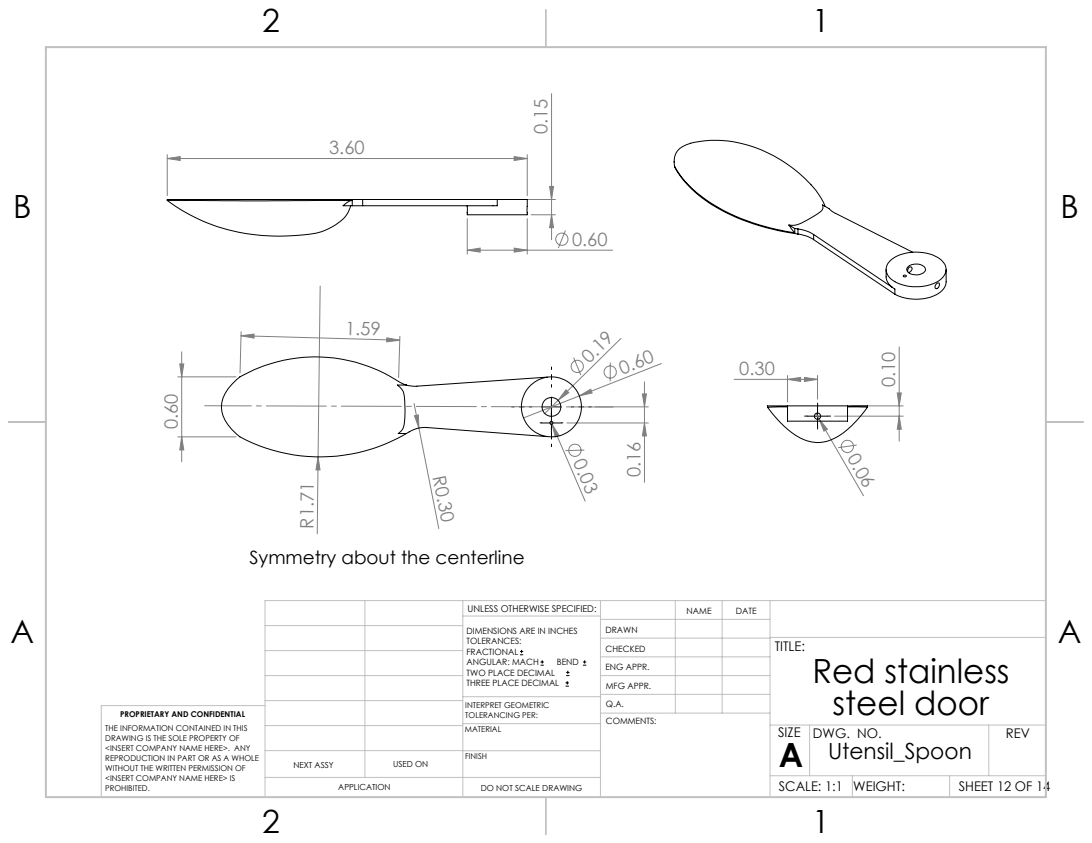
[picture p34: page 12]

Symmetry about the centerline

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

CHECKED | | | TITLE: Red stainless steel door

ENG APPR.
MFG APPR.

INTERPRET GEOMETRIC TOLERANCING PER: | Q.A.
MATERIAL | | SIZE A | DWG. NO. Utensil_Spoon | REV

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

NEXT ASSY | USED ON | FINISH

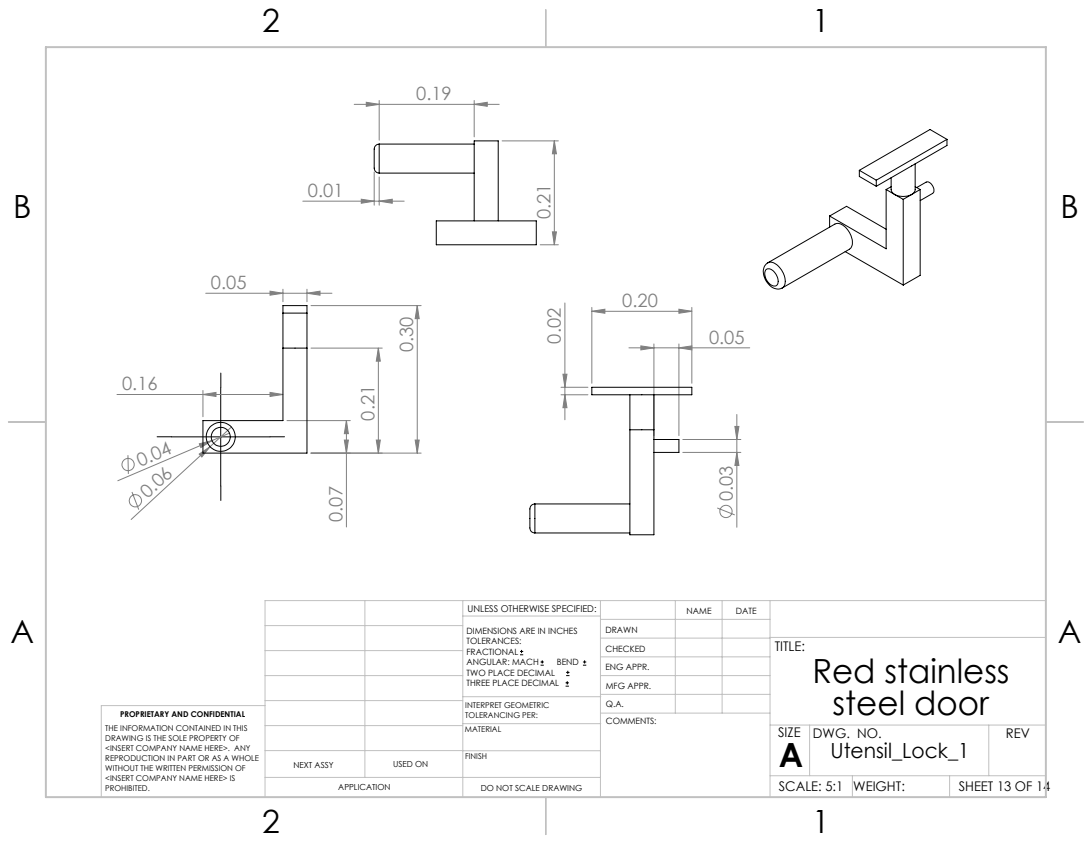
[picture p35: page 13]
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

CHECKED | | | TITLE: Red stainless steel door

ENG APPR.
MFG APPR.

INTERPRET GEOMETRIC TOLERANCING PER: | Q.A.
MATERIAL | | SIZE A | DWG. NO. Utensil_Lock_1 | REV

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

NEXT ASSY | USED ON | FINISH

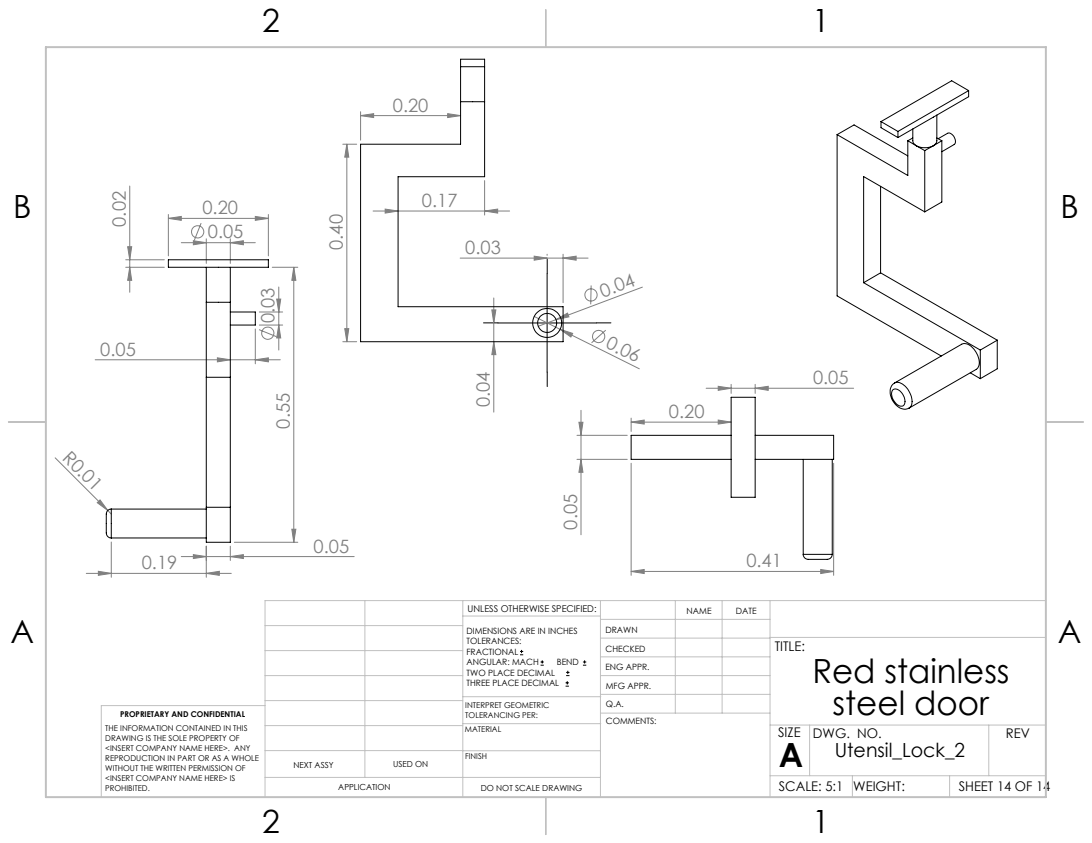
[picture p36: page 14]
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

CHECKED | | | TITLE: Red stainless steel door

ENG APPR.
MFG APPR.

INTERPRET GEOMETRIC TOLERANCING PER: | Q.A.
MATERIAL | | SIZE A | DWG. NO. Utensil_Lock_2 | REV

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

NEXT ASSY | USED ON | FINISH
