griffink3/sak-redesign/Tolerance Analysis/Engineering Drawings PDF.pdf

B B

0.380 ±0.035

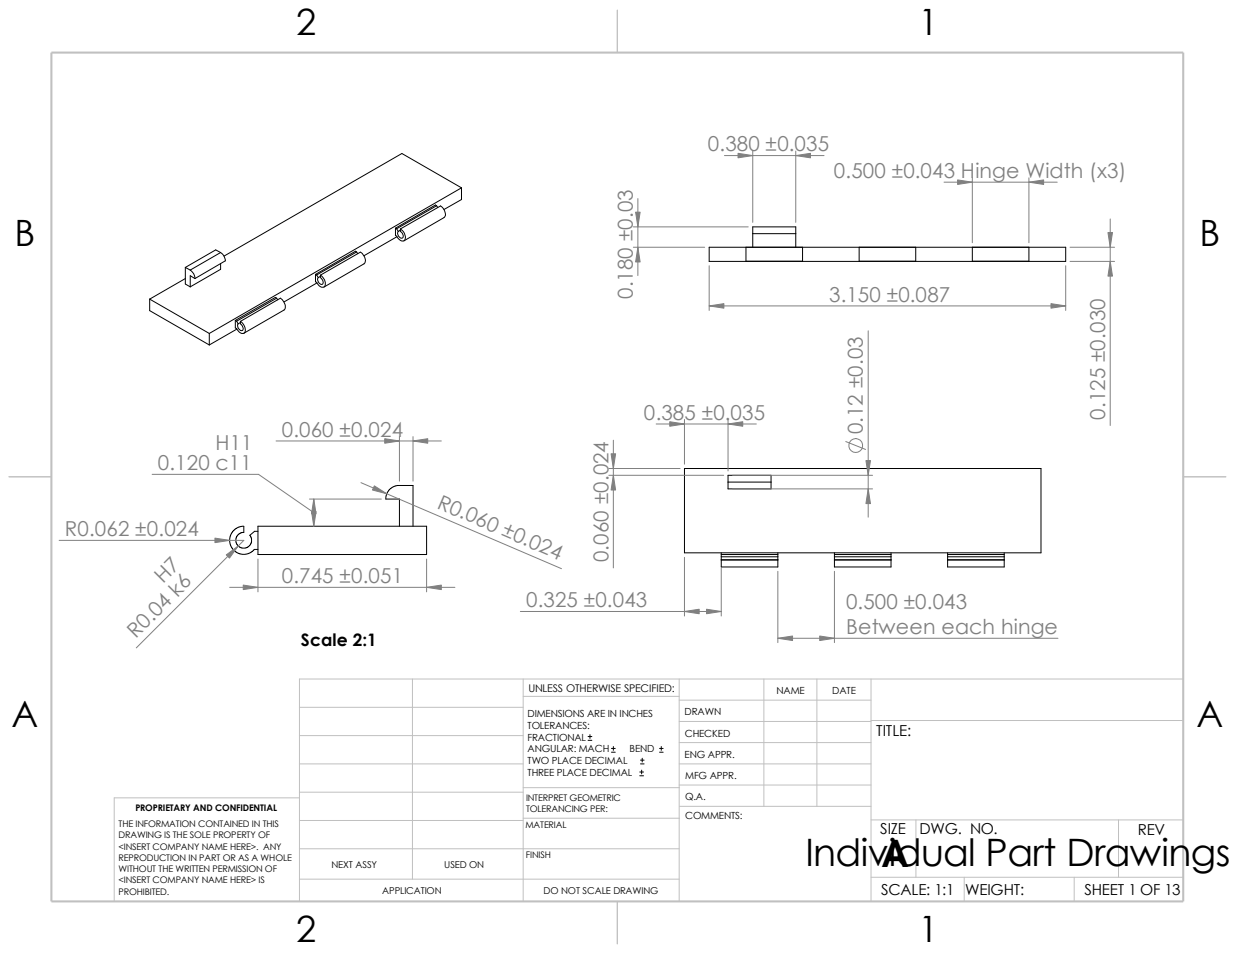
[picture p37: page 1]
Individual Part Drawings; COMMENTS:; Scale 2:1; 0.500 ±0.043 Hinge Width (x3)

Between each hinge ⁰.12 ±0.03 0.060 ±0.024

UNLESS OTHERWISE SPECIFIED: | | NAME | DATE

DIMENSIONS ARE IN INCHES TOLERANCES: FRACTIONAL ANGULAR: MACH BEND TWO PLACE DECIMAL THREE PLACE DECIMAL | DRAWN

CHECKED | | | TITLE:

ENG APPR.
MFG APPR.

INTERPRET GEOMETRIC TOLERANCING PER: | Q.A.
MATERIAL | | SIZE A | DWG. NO. | REV

PROPRIETARY AND CONFIDENTIAL
THE INFORMATION CONTAINED IN THIS
DRAWING IS THE SOLE PROPERTY OF
<INSERT COMPANY NAME HERE>. ANY
REPRODUCTION IN PART OR AS A WHOLE
WITHOUT THE WRITTEN PERMISSION OF
<INSERT COMPANY NAME HERE> IS
PROHIBITED.

NEXT ASSY | USED ON | FINISH

APPLICATION | DO NOT SCALE DRAWING | | SCALE: 1:1 | WEIGHT: | SHEET 1 OF 13

4

3

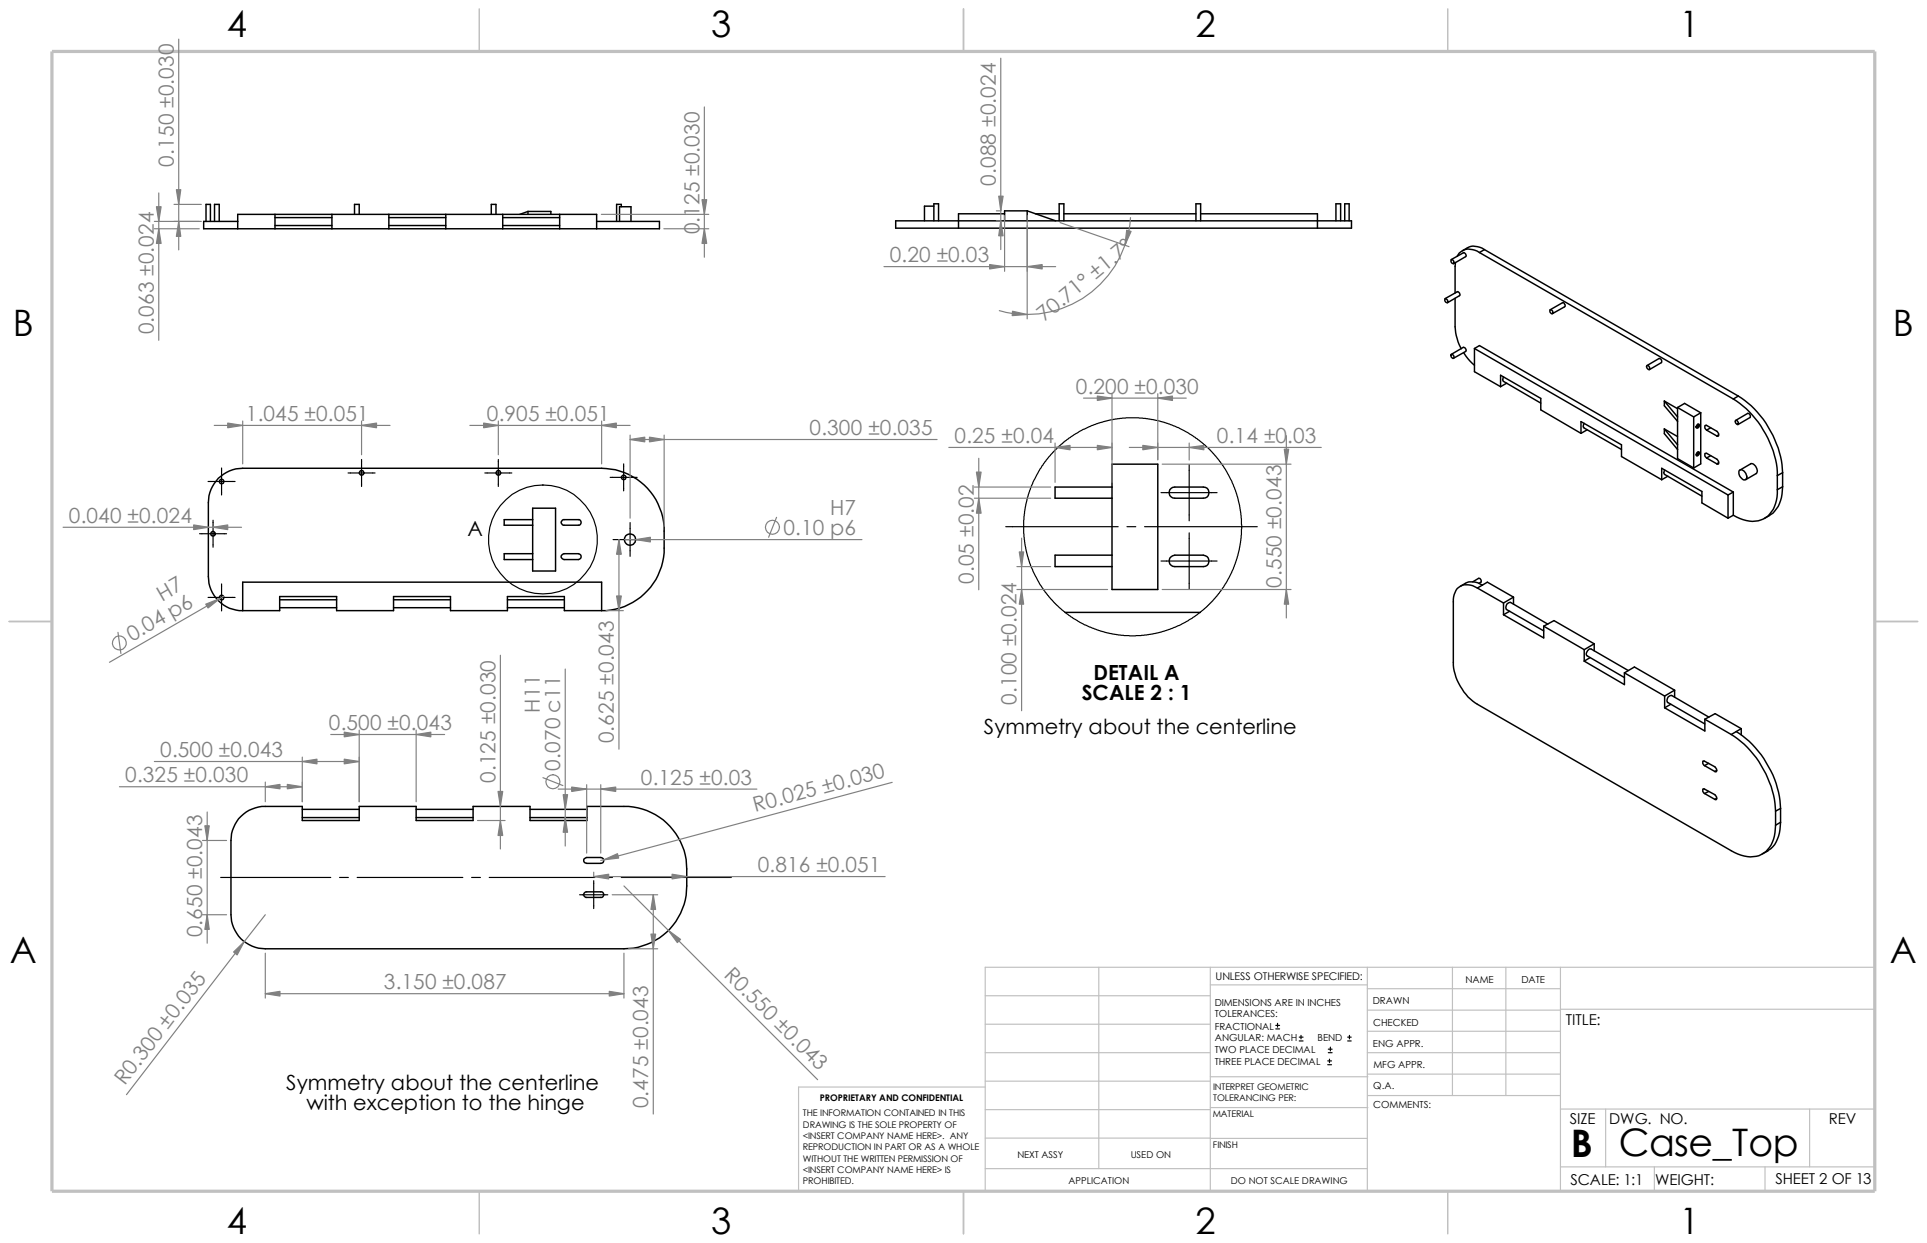
[picture p38: page 2]
COMMENTS:; 0.070 H¹¹ c¹¹; DETAIL A SCALE 2 : 1

Symmetry about the centerline

UNLESS OTHERWISE SPECIFIED: | | NAME | DATE

DIMENSIONS ARE IN INCHES TOLERANCES: FRACTIONAL ANGULAR: MACH BEND TWO PLACE DECIMAL THREE PLACE DECIMAL | DRAWN

CHECKED | | | TITLE:

ENG APPR.

with exception to the hinge

MFG APPR.

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

INTERPRET GEOMETRIC TOLERANCING PER: | Q.A.
MATERIAL | | SIZE B | DWG. NO. Case_Top | REV

NEXT ASSY | USED ON | FINISH

APPLICATION | DO NOT SCALE DRAWING | | SCALE: 1:1 | WEIGHT: | SHEET 2 OF 13

4

3

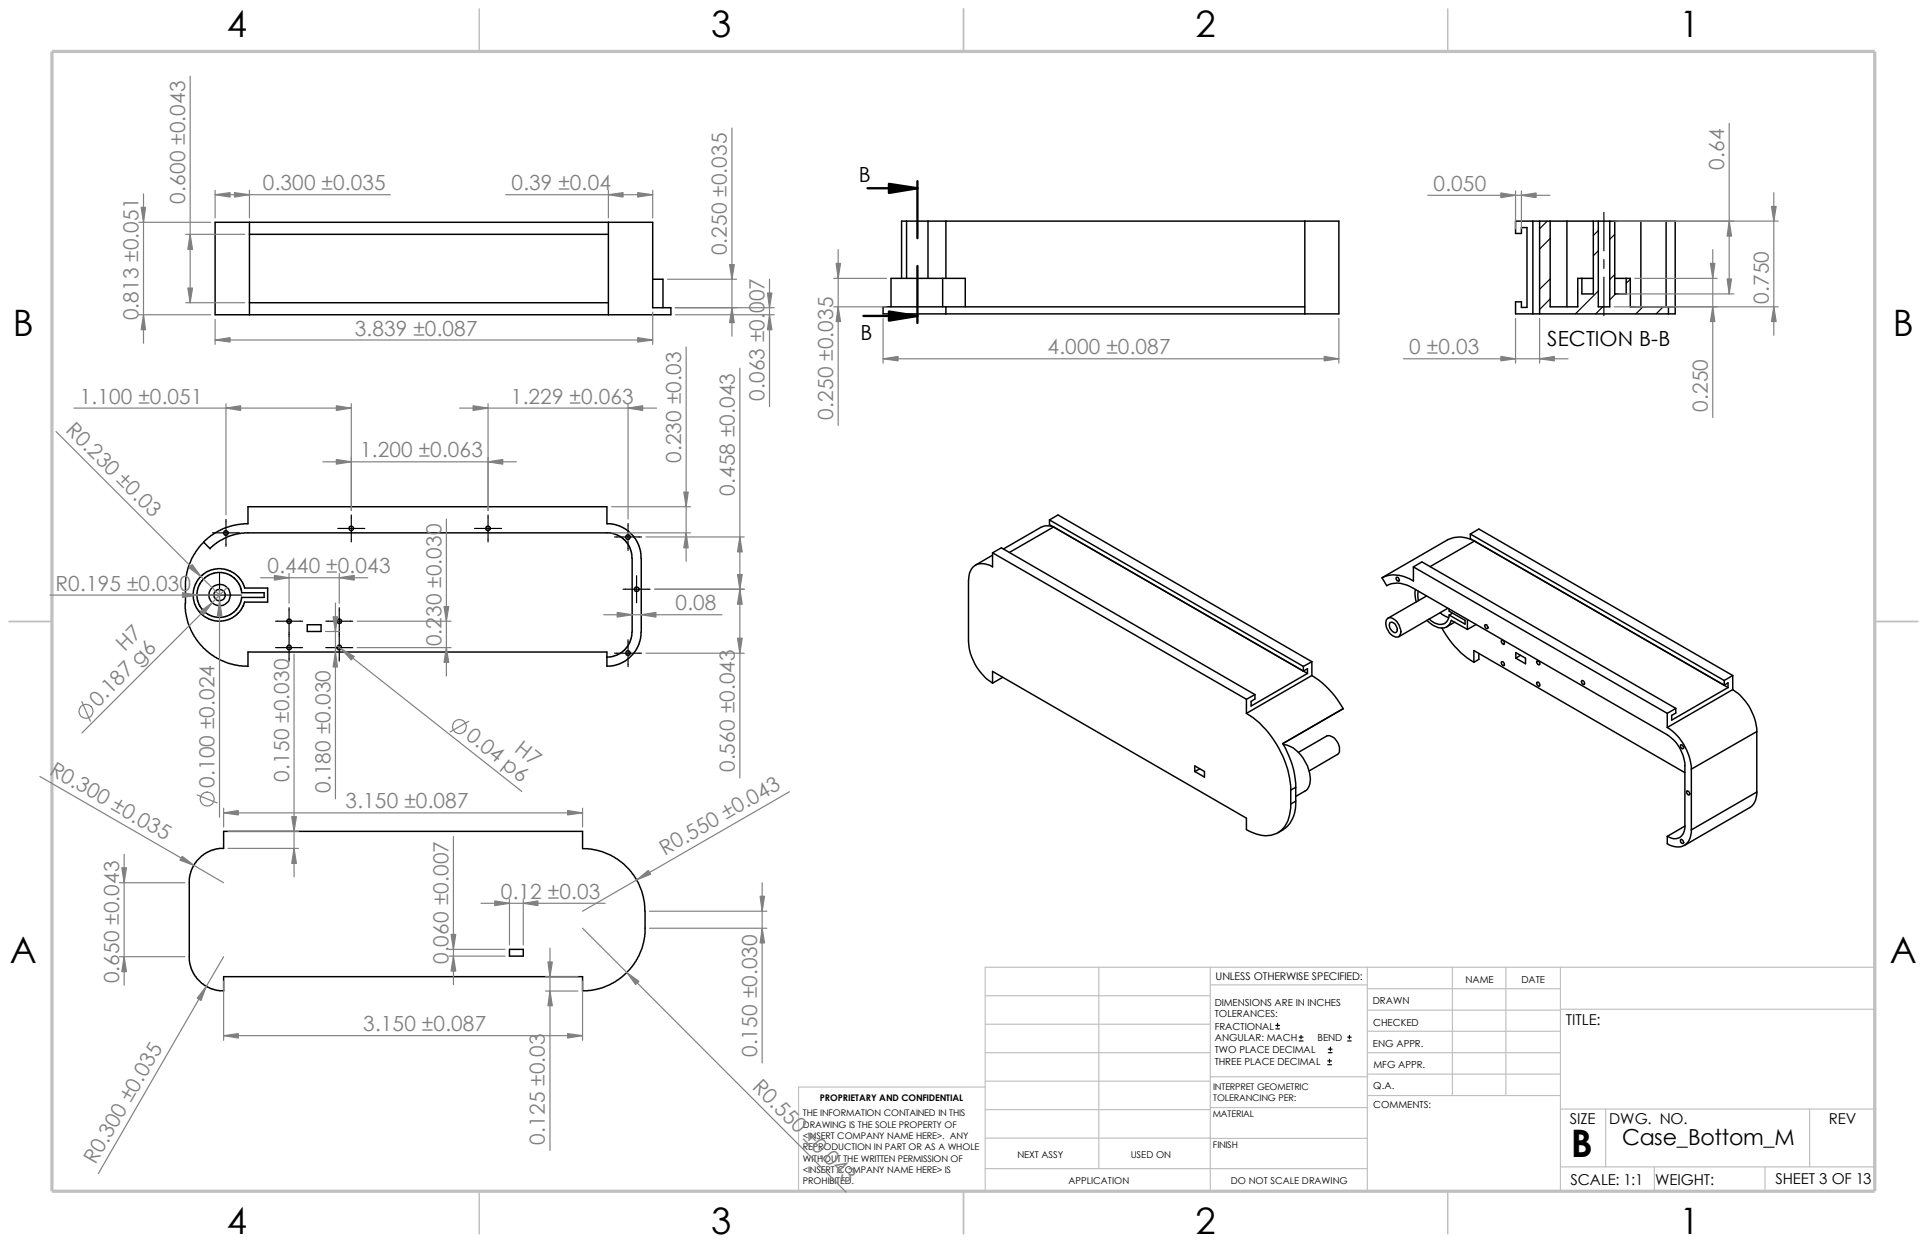
[picture p39: page 3]
COMMENTS:; PROHIBITED. 0.813 ±0.051; SECTION B-B 0.250 0.64

UNLESS OTHERWISE SPECIFIED: | | NAME | DATE

DIMENSIONS ARE IN INCHES TOLERANCES: FRACTIONAL ANGULAR: MACH BEND TWO PLACE DECIMAL THREE PLACE DECIMAL | DRAWN

CHECKED | | | TITLE:

ENG APPR.

MFG APPR.

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

INTERPRET GEOMETRIC TOLERANCING PER: | Q.A.
MATERIAL | | SIZE B | DWG. NO. Case_Bottom_M | REV

NEXT ASSY | USED ON | FINISH

APPLICATION | DO NOT SCALE DRAWING | | SCALE: 1:1 | WEIGHT: | SHEET 3 OF 13

B B

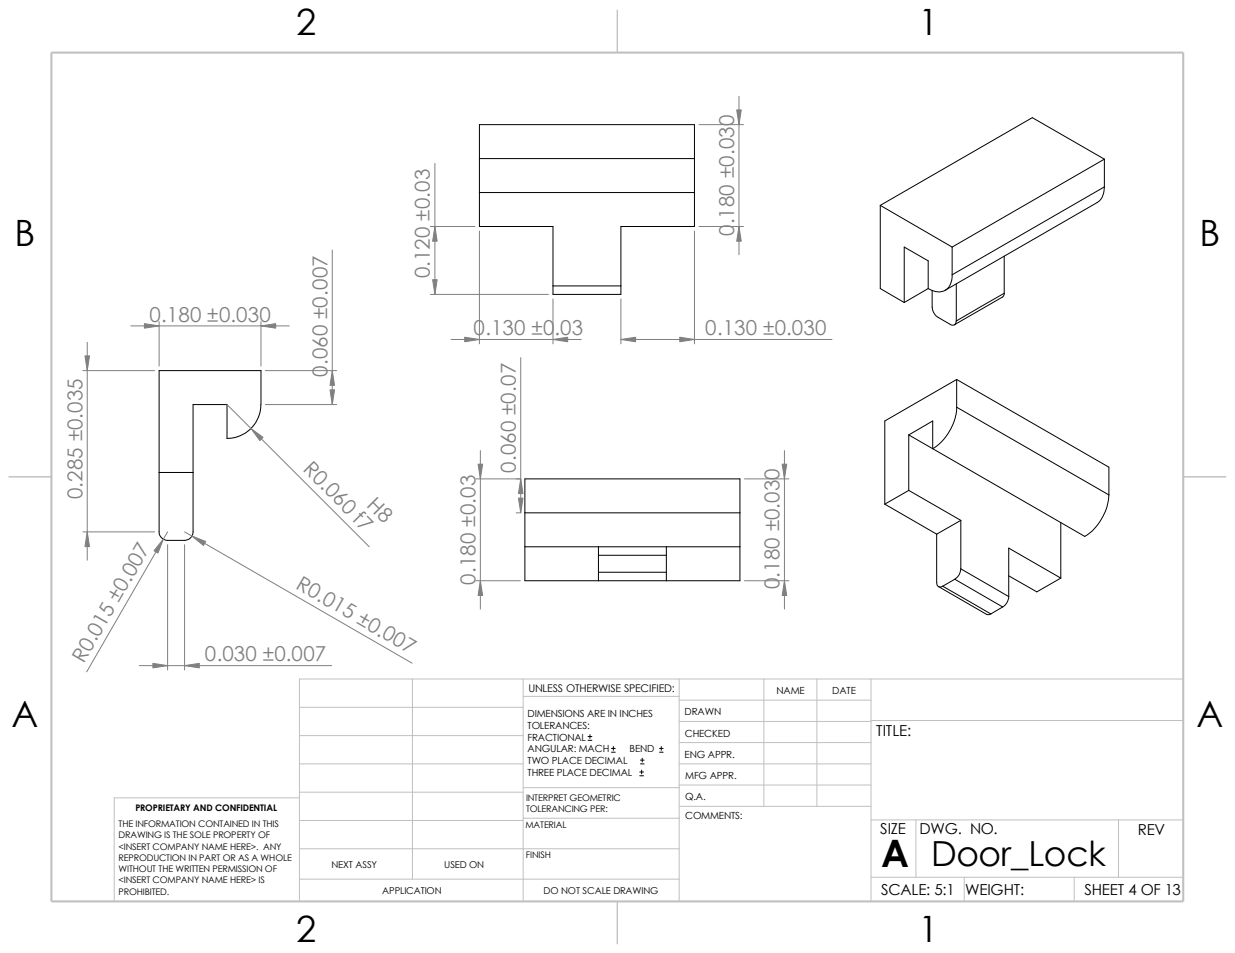
[picture p40: page 4]
COMMENTS:; PROHIBITED.

UNLESS OTHERWISE SPECIFIED: | | NAME | DATE

DIMENSIONS ARE IN INCHES TOLERANCES: FRACTIONAL ANGULAR: MACH BEND TWO PLACE DECIMAL THREE PLACE DECIMAL | DRAWN

CHECKED | | | TITLE:

ENG APPR.
MFG APPR.

INTERPRET GEOMETRIC TOLERANCING PER: | Q.A.
MATERIAL | | SIZE A | DWG. NO. Door_Lock | REV

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

NEXT ASSY | USED ON | FINISH

SCALE: 5:1 | WEIGHT: | SHEET 4 OF 13

B B

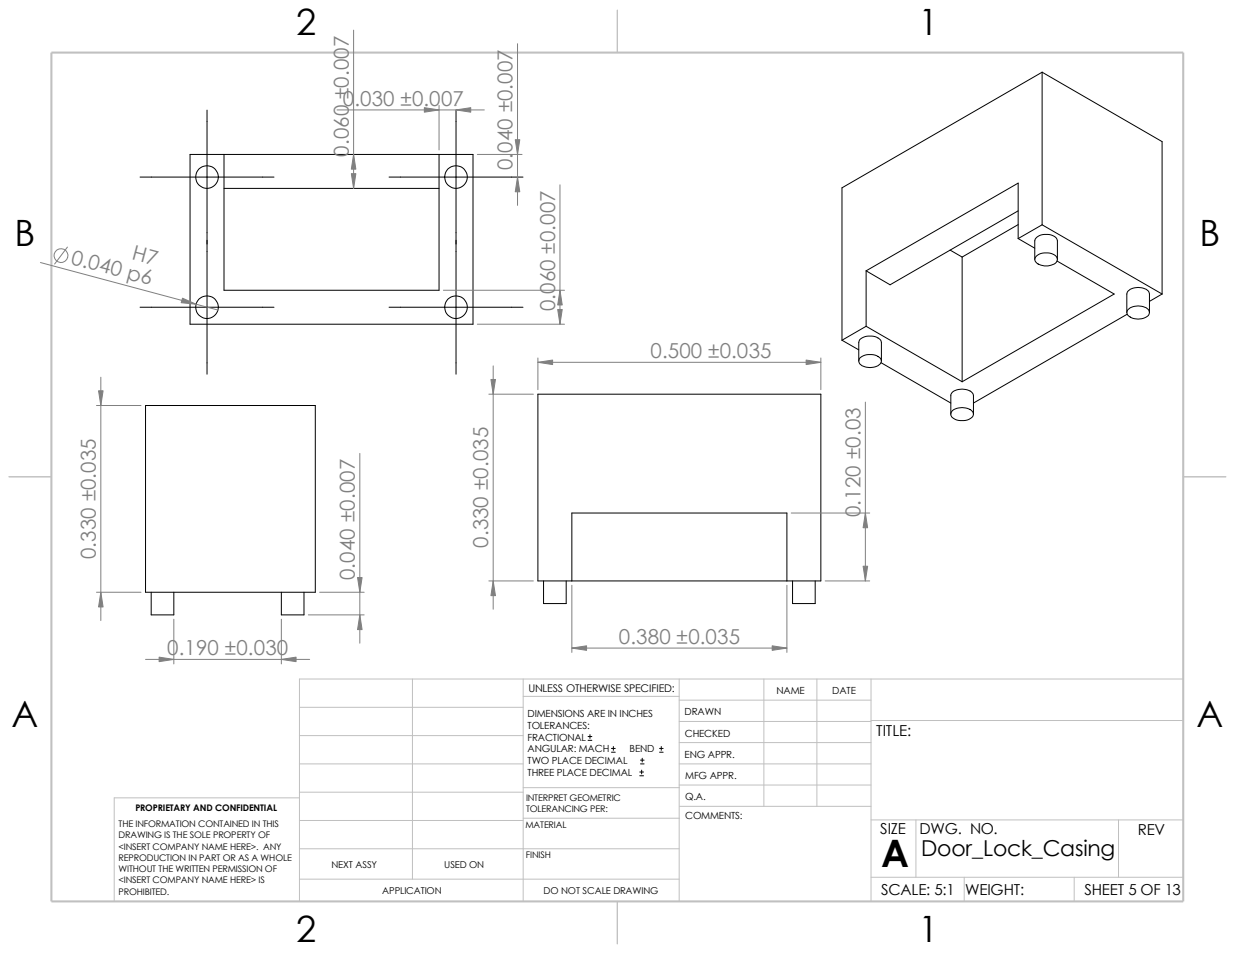
[picture p41: page 5]
COMMENTS:; PROHIBITED.

UNLESS OTHERWISE SPECIFIED: | | NAME | DATE

DIMENSIONS ARE IN INCHES TOLERANCES: FRACTIONAL ANGULAR: MACH BEND TWO PLACE DECIMAL THREE PLACE DECIMAL | DRAWN

CHECKED | | | TITLE:

ENG APPR.
MFG APPR.

INTERPRET GEOMETRIC TOLERANCING PER: | Q.A.
MATERIAL | | SIZE A | DWG. NO. Door_Lock_Casing | REV

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

NEXT ASSY | USED ON | FINISH

SHEET 5 OF 13

B B
0.250 ±0.030 0.040 ±0.007

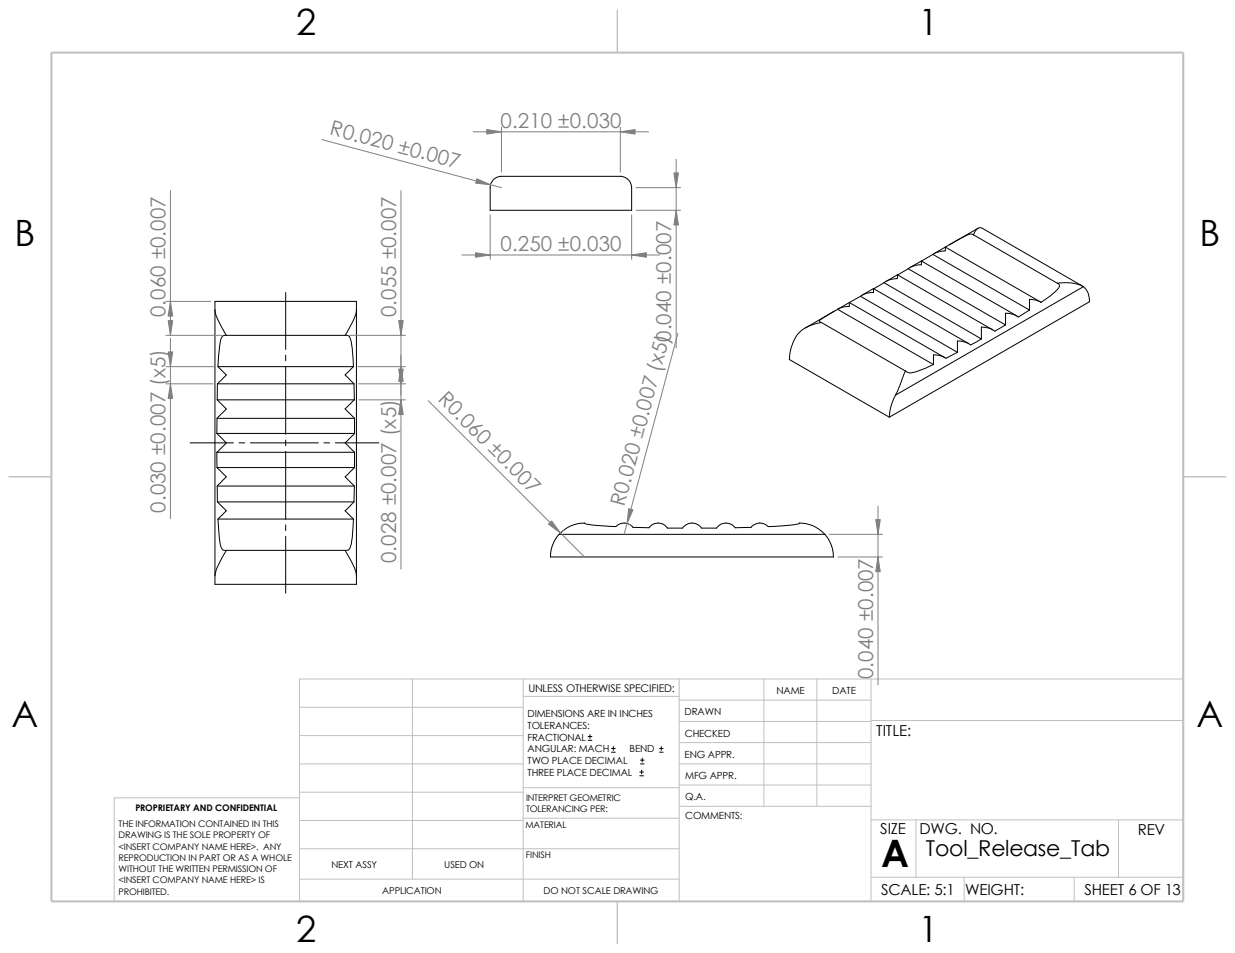
[picture p42: page 6]
COMMENTS:

UNLESS OTHERWISE SPECIFIED: | | NAME | DATE

DIMENSIONS ARE IN INCHES TOLERANCES: FRACTIONAL ANGULAR: MACH BEND TWO PLACE DECIMAL THREE PLACE DECIMAL | DRAWN

CHECKED | | | TITLE:

ENG APPR.
MFG APPR.

INTERPRET GEOMETRIC TOLERANCING PER: | Q.A.
MATERIAL | | SIZE A | DWG. NO. Tool_Release_Tab | REV

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

NEXT ASSY | USED ON | FINISH

SHEET 6 OF 13

B B

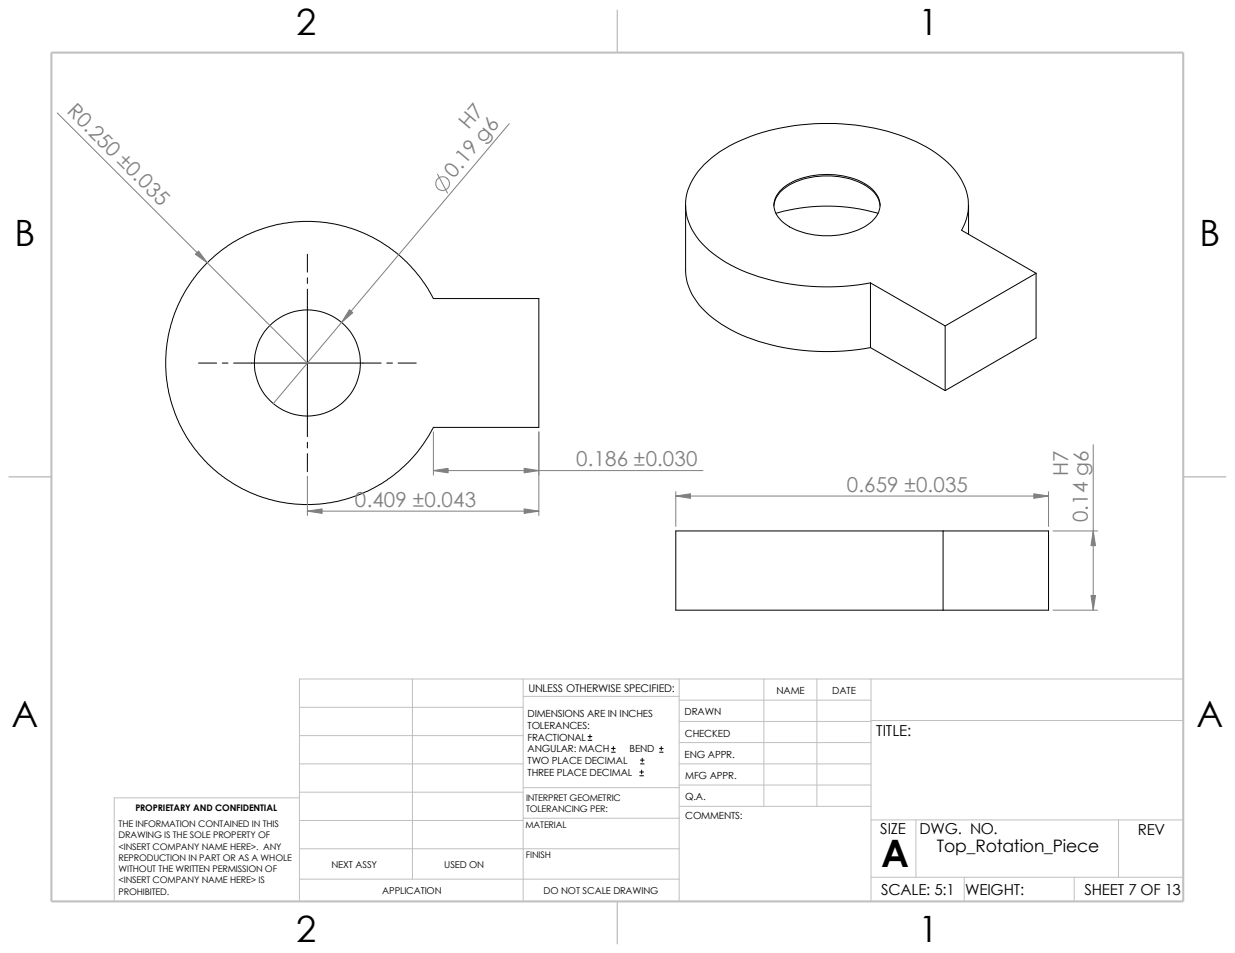
[picture p43: page 7]
COMMENTS:; 0.14 H⁷g⁶

UNLESS OTHERWISE SPECIFIED: | | NAME | DATE

DIMENSIONS ARE IN INCHES TOLERANCES: FRACTIONAL ANGULAR: MACH BEND TWO PLACE DECIMAL THREE PLACE DECIMAL | DRAWN

CHECKED | | | TITLE:

ENG APPR.
MFG APPR.

INTERPRET GEOMETRIC TOLERANCING PER: | Q.A.
MATERIAL | | SIZE A | DWG. NO. Top_Rotation_Piece | REV

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

NEXT ASSY | USED ON | FINISH

SHEET 7 OF 13

B B

0.580 ±0.043 ⁰.063 ±0.007 0.350 ±0.030 | 2.011 ±0.063

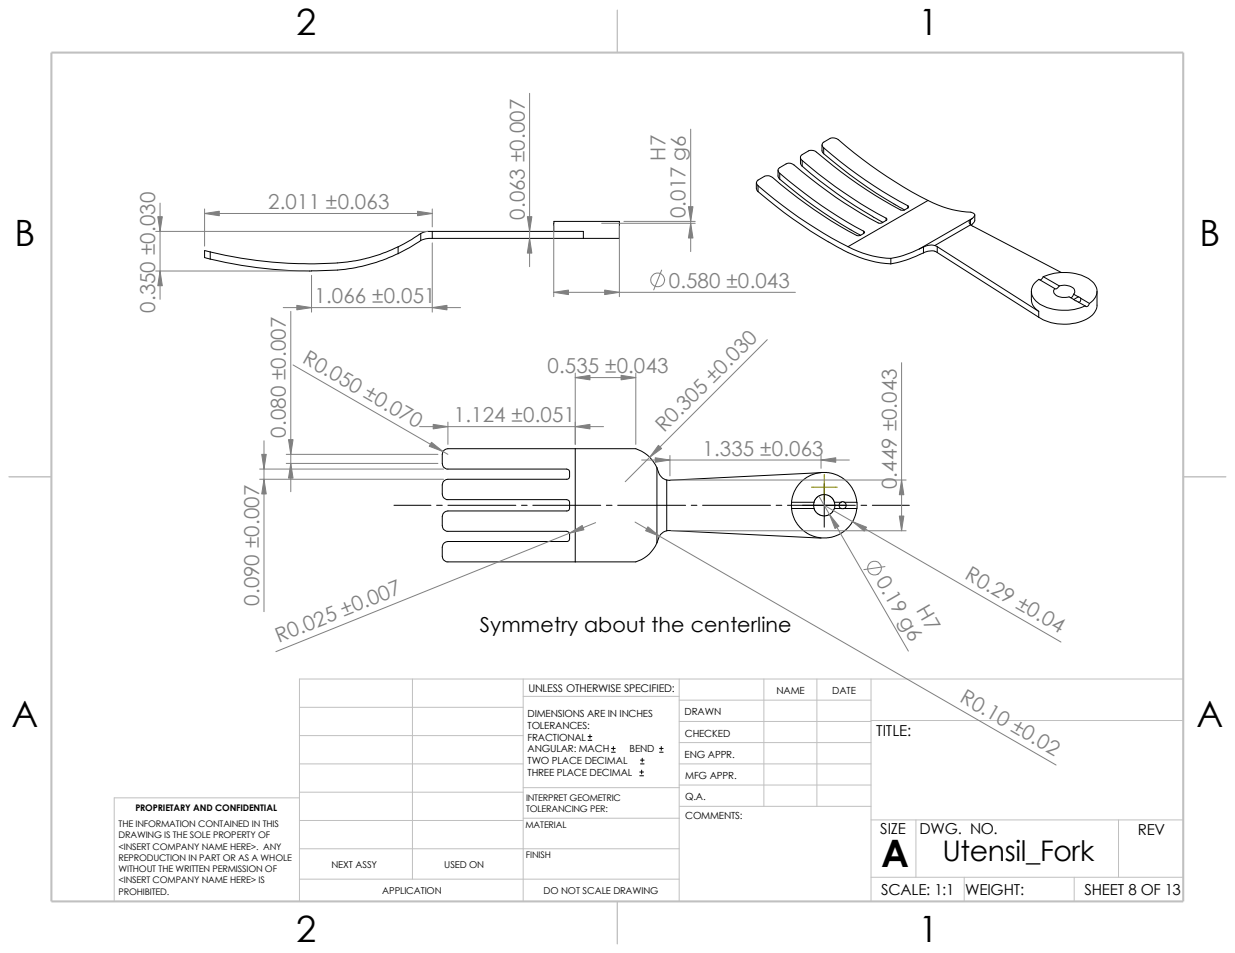
[picture p44: page 8]
COMMENTS:; PROHIBITED.; 0.017 H⁷g⁶

Symmetry about the centerline

UNLESS OTHERWISE SPECIFIED: | | NAME | DATE

DIMENSIONS ARE IN INCHES TOLERANCES: FRACTIONAL ANGULAR: MACH BEND TWO PLACE DECIMAL THREE PLACE DECIMAL | DRAWN

CHECKED | | | TITLE:

ENG APPR.
MFG APPR.

INTERPRET GEOMETRIC TOLERANCING PER: | Q.A.
MATERIAL | | SIZE A | DWG. NO. Utensil_Fork | REV

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

NEXT ASSY | USED ON | FINISH

SCALE: 1:1 | WEIGHT: | SHEET 8 OF 13

B B

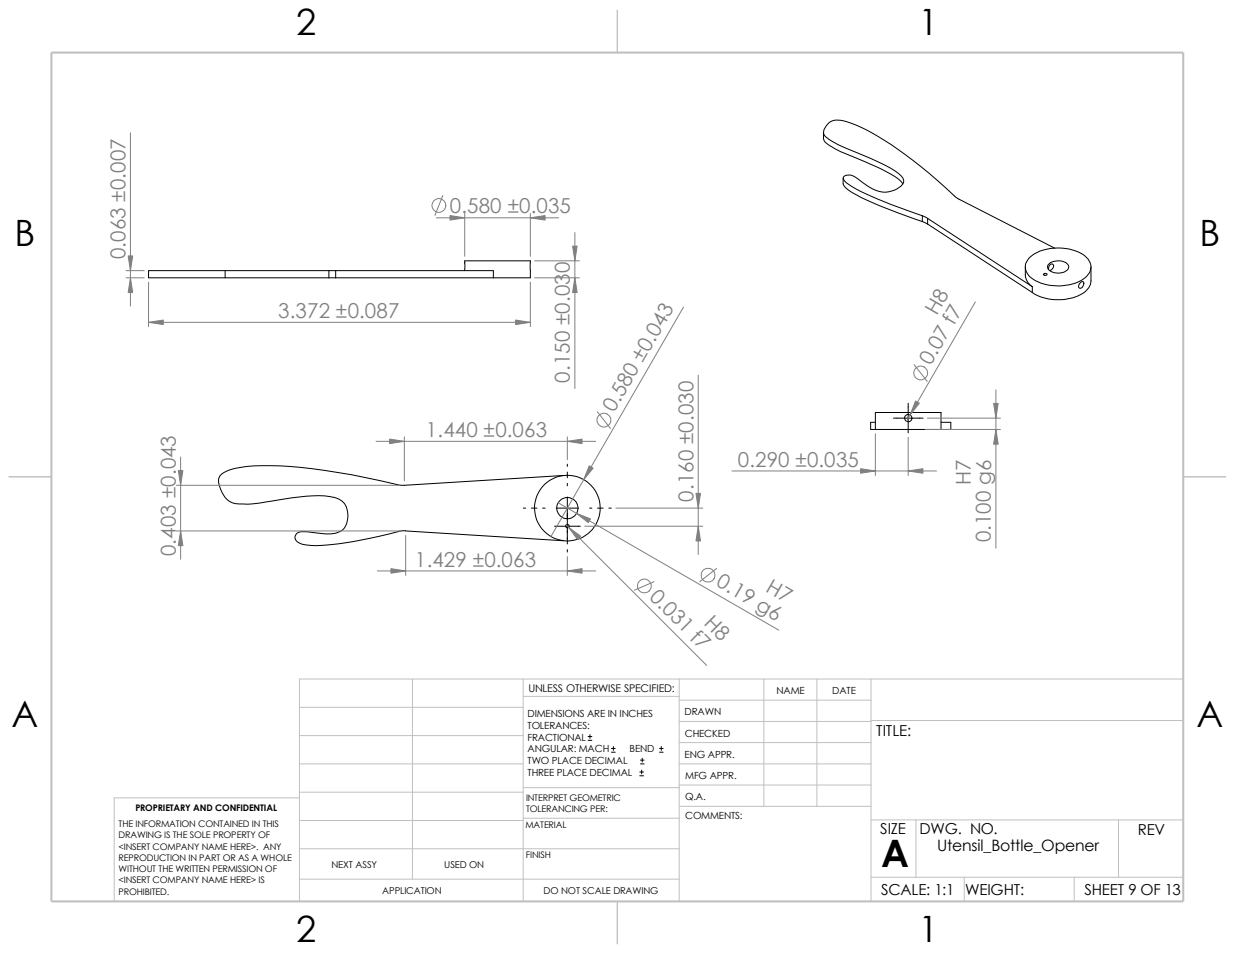
[picture p45: page 9]
COMMENTS:

UNLESS OTHERWISE SPECIFIED: | | NAME | DATE

DIMENSIONS ARE IN INCHES TOLERANCES: FRACTIONAL ANGULAR: MACH BEND TWO PLACE DECIMAL THREE PLACE DECIMAL | DRAWN

CHECKED | | | TITLE:

ENG APPR.
MFG APPR.

INTERPRET GEOMETRIC TOLERANCING PER: | Q.A.
MATERIAL | | SIZE A | DWG. NO. Utensil_Bottle_Opener | REV

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

NEXT ASSY | USED ON | FINISH

SCALE: 1:1 | WEIGHT: | SHEET 9 OF 13

B B

2.187 ±0.063 | 1.407 ±0.063 | 0.150 ±0.030

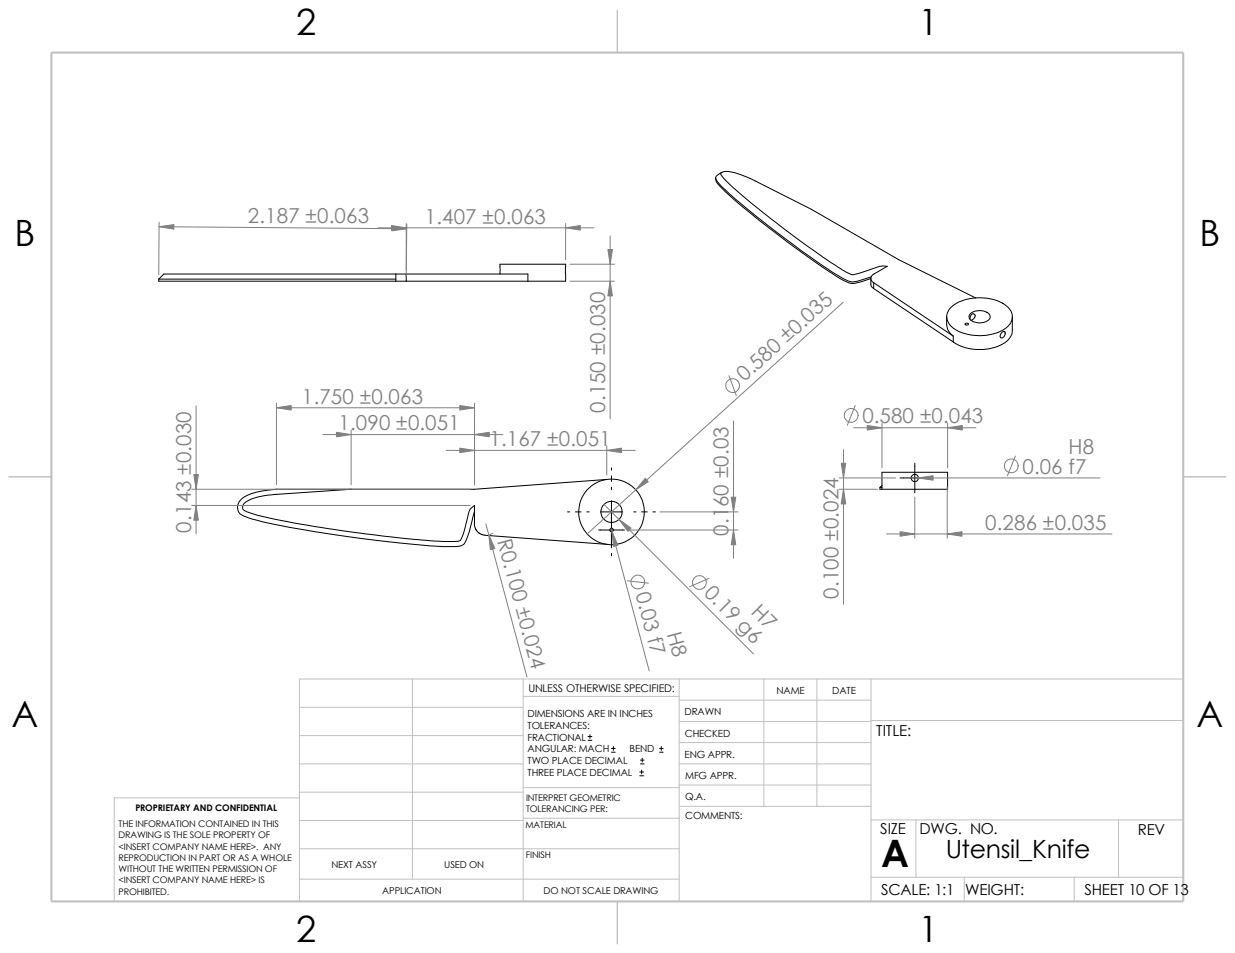
[picture p46: page 10]
SHEET 10 OF 13; COMMENTS:

UNLESS OTHERWISE SPECIFIED: | | NAME | DATE

DIMENSIONS ARE IN INCHES TOLERANCES: FRACTIONAL ANGULAR: MACH BEND TWO PLACE DECIMAL THREE PLACE DECIMAL | DRAWN

CHECKED | | | TITLE:

ENG APPR.
MFG APPR.

INTERPRET GEOMETRIC TOLERANCING PER: | Q.A.
MATERIAL | | SIZE A | DWG. NO. Utensil_Knife | REV

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

NEXT ASSY | USED ON | FINISH

SCALE: 1:1 | WEIGHT:

B B

3.600 ±0.087

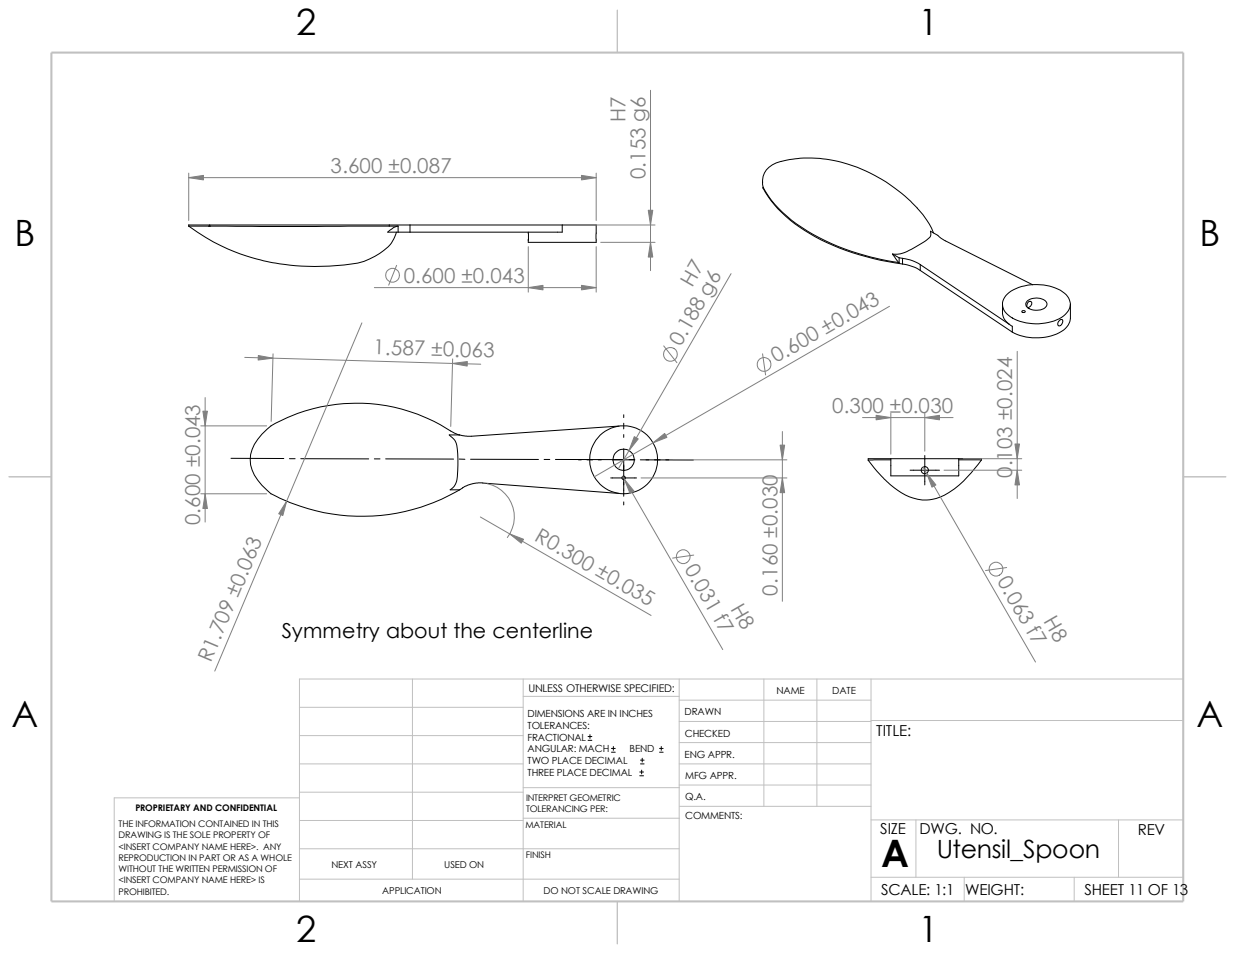
[picture p47: page 11]
SHEET 11 OF 13; COMMENTS:; 0.153 H⁷g⁶

Symmetry about the centerline

UNLESS OTHERWISE SPECIFIED: | | NAME | DATE

DIMENSIONS ARE IN INCHES TOLERANCES: FRACTIONAL ANGULAR: MACH BEND TWO PLACE DECIMAL THREE PLACE DECIMAL | DRAWN

CHECKED | | | TITLE:

ENG APPR.
MFG APPR.

INTERPRET GEOMETRIC TOLERANCING PER: | Q.A.
MATERIAL | | SIZE A | DWG. NO. Utensil_Spoon | REV

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

NEXT ASSY | USED ON | FINISH

SCALE: 1:1 | WEIGHT:

B B

0.160 ±0.030 | 0.21 ±0.03 | 0.295 ±0.035 0.048 ±0.007 | 0.208 ±0.030

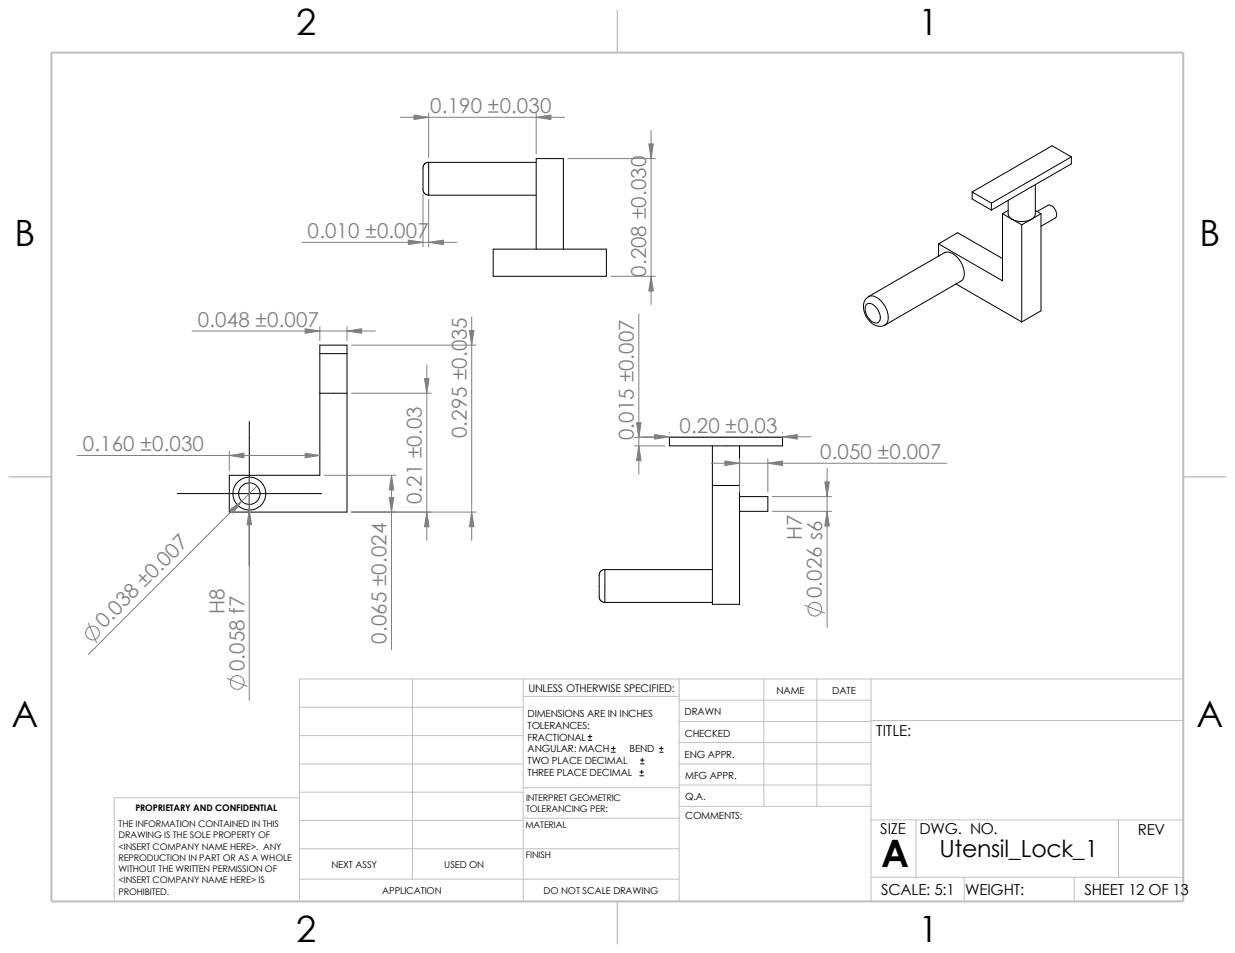
[picture p48: page 12]
SHEET 12 OF 13; COMMENTS:; 0.026 H⁷s6

UNLESS OTHERWISE SPECIFIED: | | NAME | DATE

DIMENSIONS ARE IN INCHES TOLERANCES: FRACTIONAL ANGULAR: MACH BEND TWO PLACE DECIMAL THREE PLACE DECIMAL | DRAWN

CHECKED | | | TITLE:

ENG APPR.
MFG APPR.

INTERPRET GEOMETRIC TOLERANCING PER: | Q.A.
MATERIAL | | SIZE A | DWG. NO. Utensil_Lock_1 | REV

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

NEXT ASSY | USED ON | FINISH

B B

0.200 ±0.03

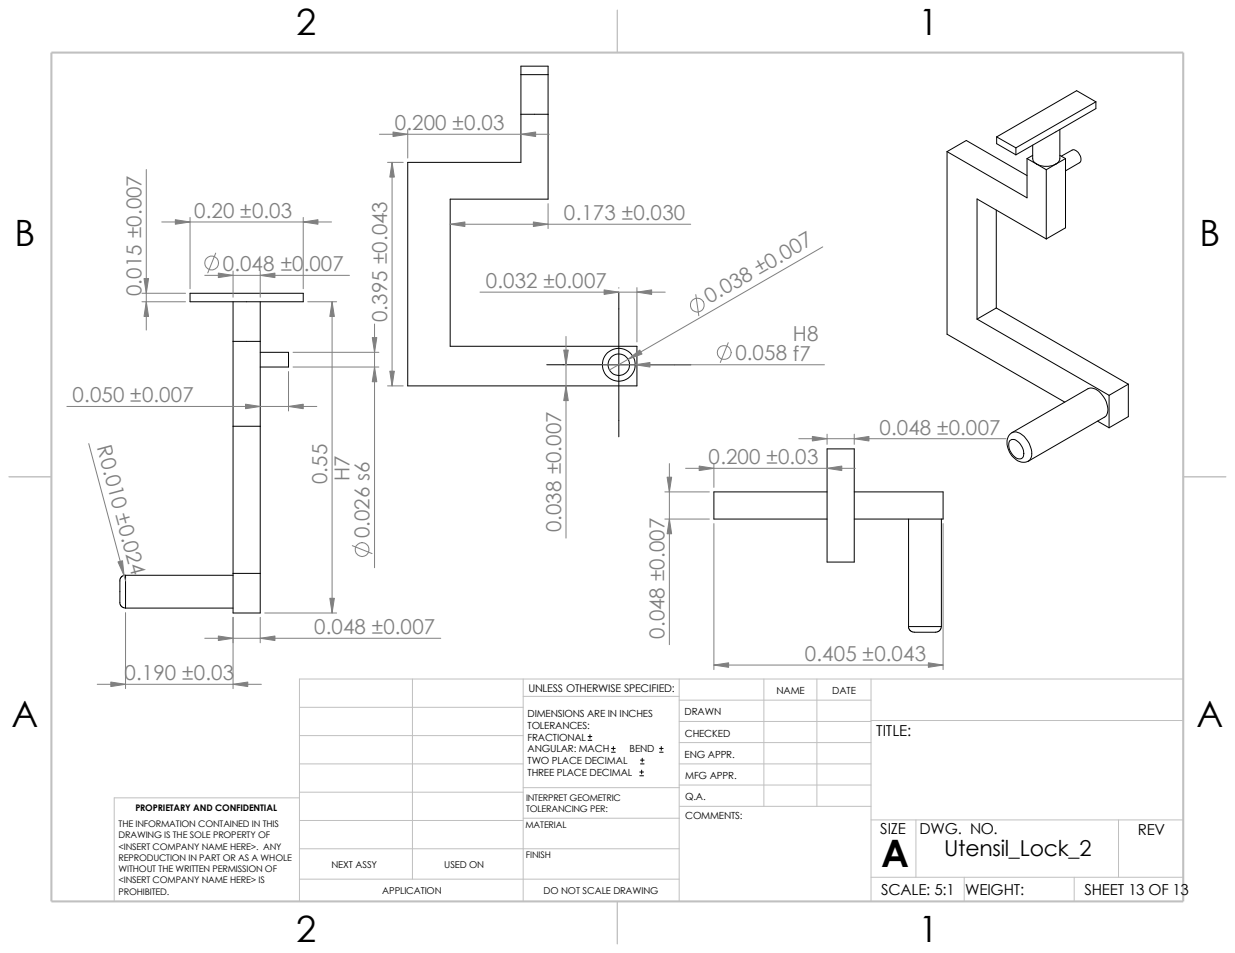
[picture p49: page 13]
SHEET 13 OF 13; COMMENTS:; PROHIBITED.; 0.026 H⁷s6

UNLESS OTHERWISE SPECIFIED: | | NAME | DATE

DIMENSIONS ARE IN INCHES TOLERANCES: FRACTIONAL ANGULAR: MACH BEND TWO PLACE DECIMAL THREE PLACE DECIMAL | DRAWN

CHECKED | | | TITLE:

ENG APPR.
MFG APPR.

INTERPRET GEOMETRIC TOLERANCING PER: | Q.A.
MATERIAL | | SIZE A | DWG. NO. Utensil_Lock_2 | REV

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

NEXT ASSY | USED ON | FINISH
